sckzor/CMOS_LNB/Layout/Layout.md

# Low Noise Amplifier Layout
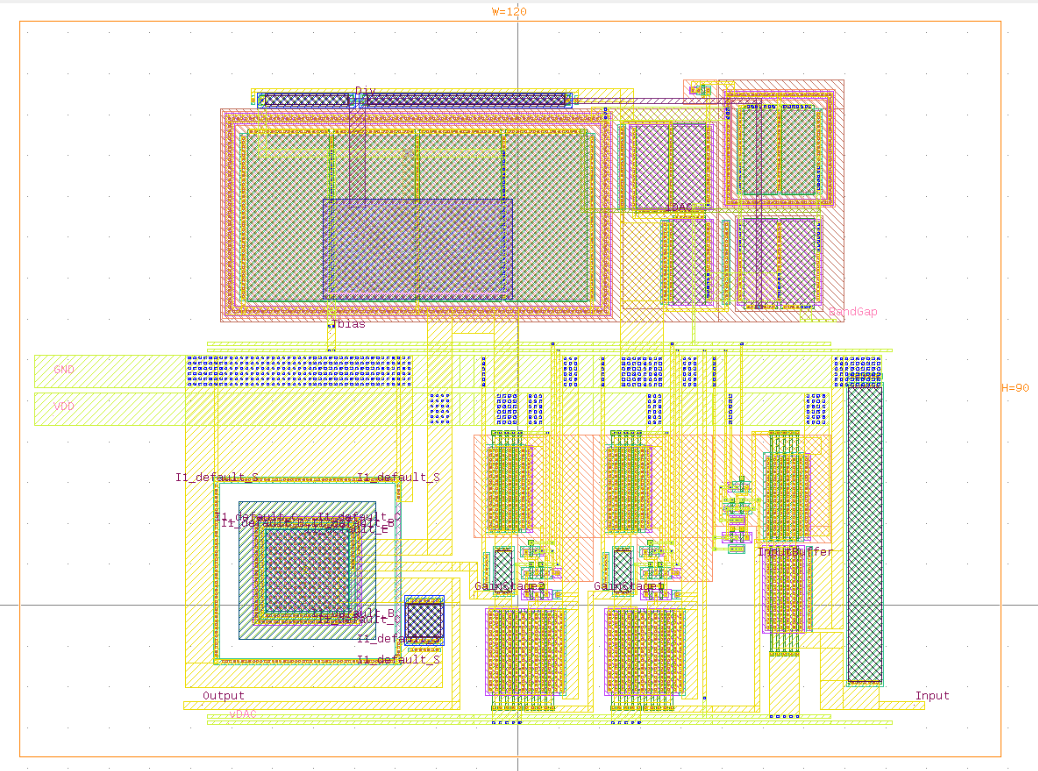
[picture p3: Images/LNA_Layout.png]
LNA Layout


*LNA Layout GDS files available at: /Layout/LNA/LNAMkV.klay.gds*

Above is the layout for the L-Band LNA presented prior.  The simulation test results are available [here](/Layout/LNA/Simulations.md).

## Input Buffer
### Input Buffer Layout
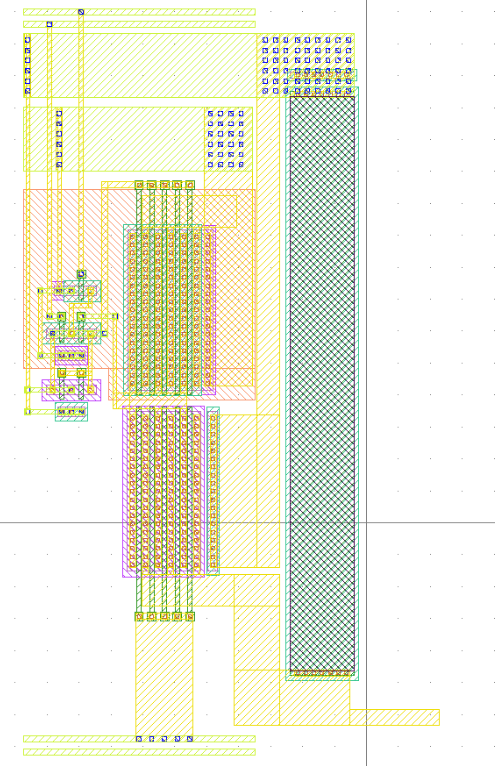
[picture p4: Images/InputBuffer_Layout.png]
Input Buffer Layout


### Input Buffer Layout Driven Schematic
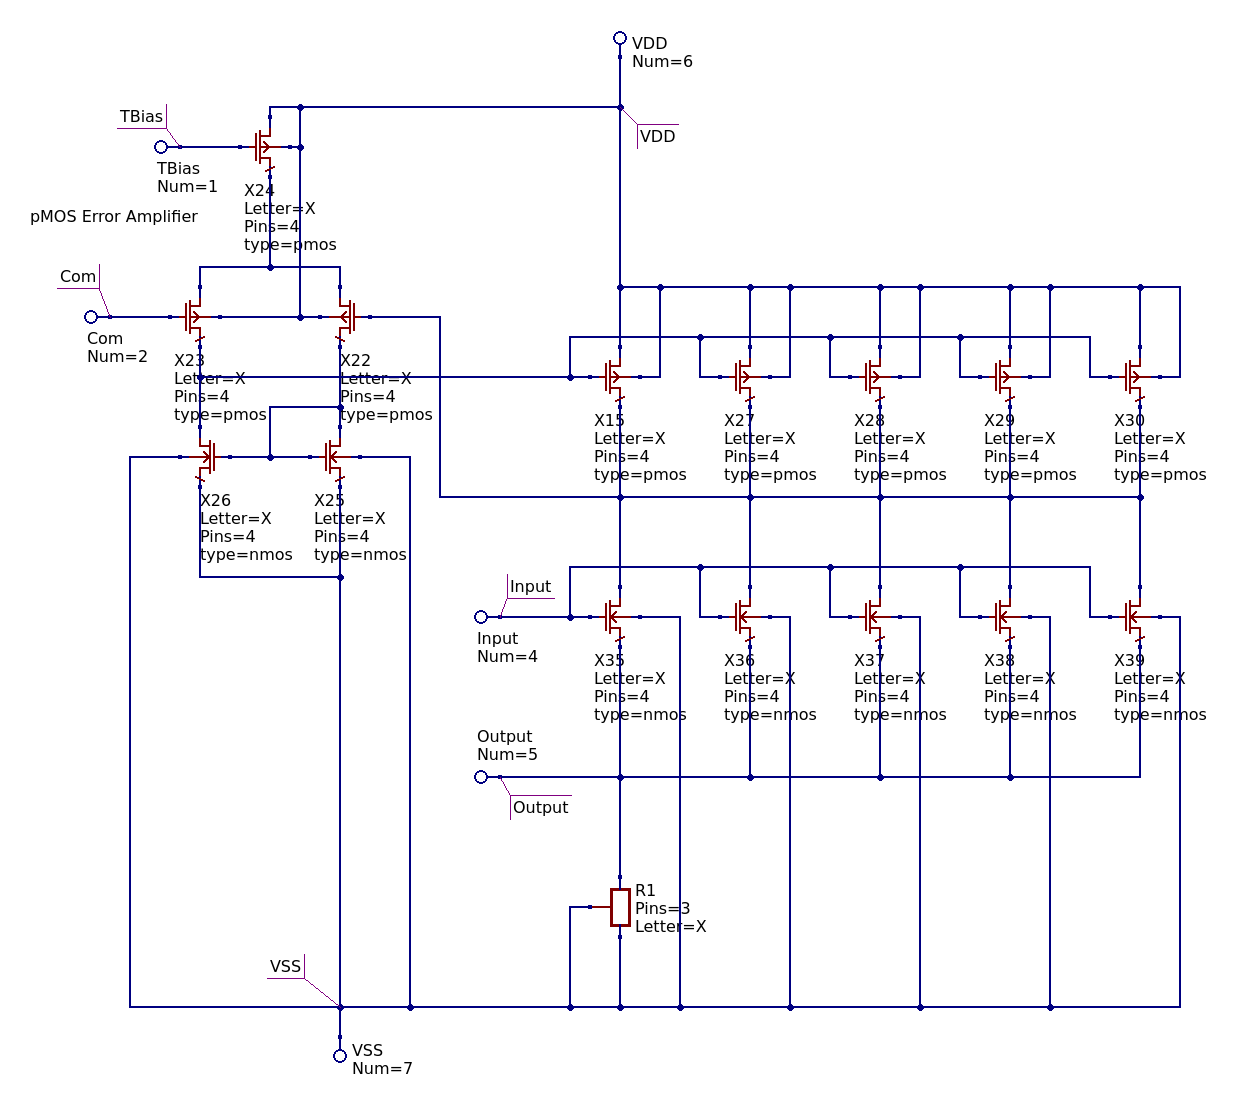
[picture p5: Images/InputBuffer_LDS.png]
Input Buffer LDS

*The LVS schematic is available at: /Schematic/Input Buffer/InputBufferMkI_LVS.sch*

### Input Buffer LVS Results
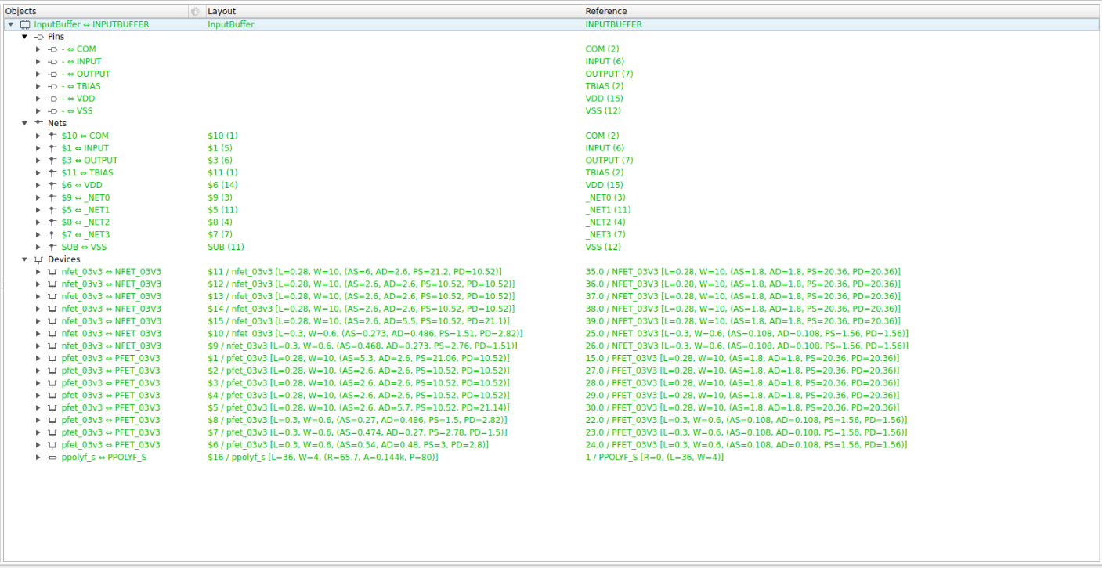
[picture p6: Images/InputBuffer_LVS.png]
Input Buffer LVS


## Gain Stage
### Gain Stage Layout
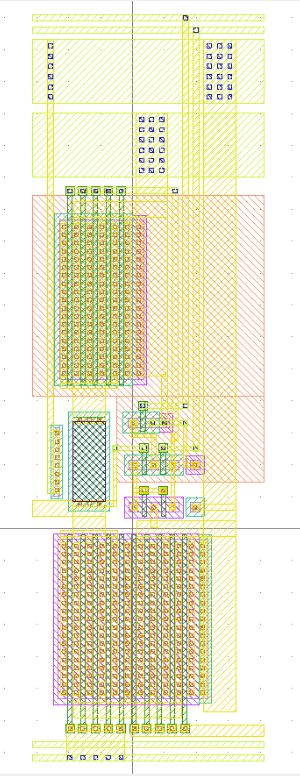
[picture p7: Images/GainStage_Layout.png]
Gain Stage Layout


### Gain Stage Layout Driven Schematic
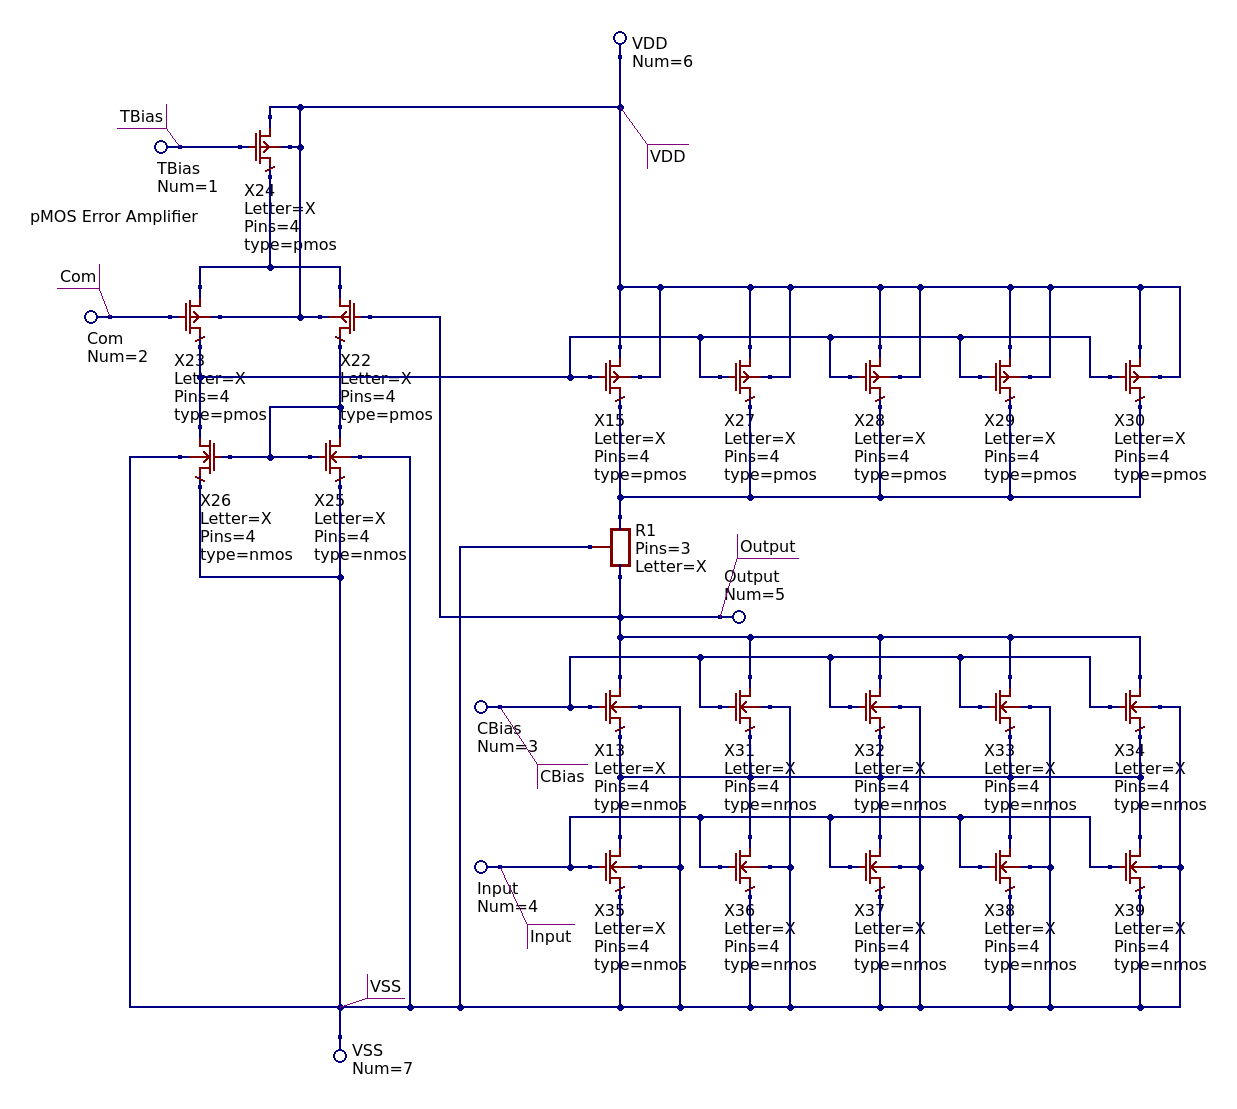
[picture p8: Images/GainStage_LDS.png]
Gain Stage LDS

*The LVS schematic is available at: /Schematic/Gain Stage/GainStageMkII_LVS.sch*

### Gain Stage LVS Results
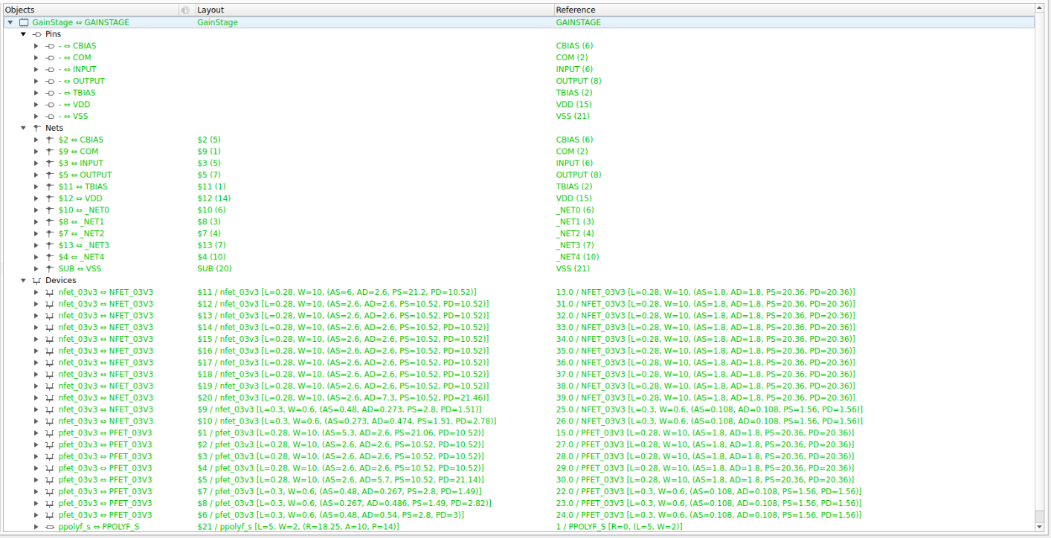
[picture p9: Images/GainStage_LVS.png]
Gain Stage LVS


## Output Buffer
### Output Buffer Layout
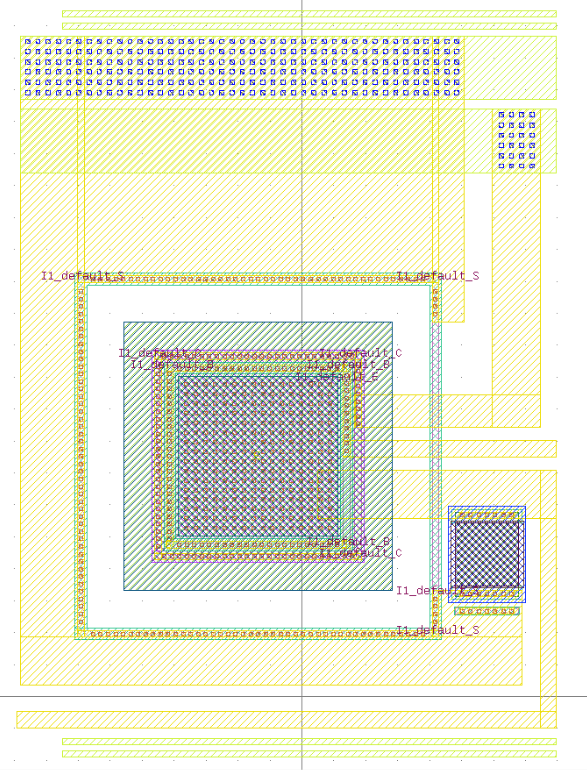
[picture p10: Images/OutputBuffer_Layout.png]
Output Buffer Layout


### Output Buffer Layout Driven Schematic
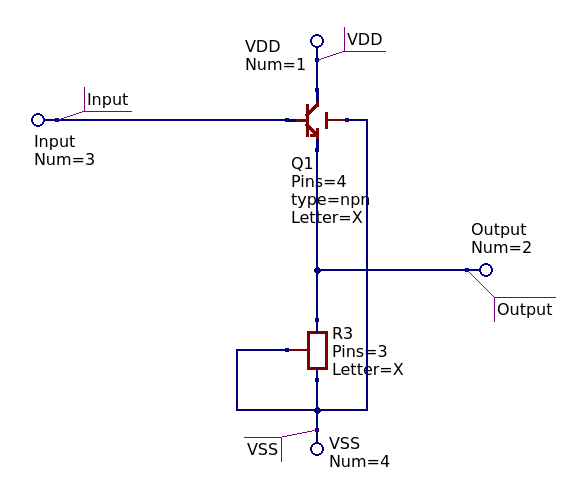
[picture p11: Images/OutputBuffer_LDS.png]
Output Buffer LDS

*The LVS schematic is available at: /Schematic/Output Buffer/OutputBufferMkVI_LVS.sch*

### Output Buffer LVS Results
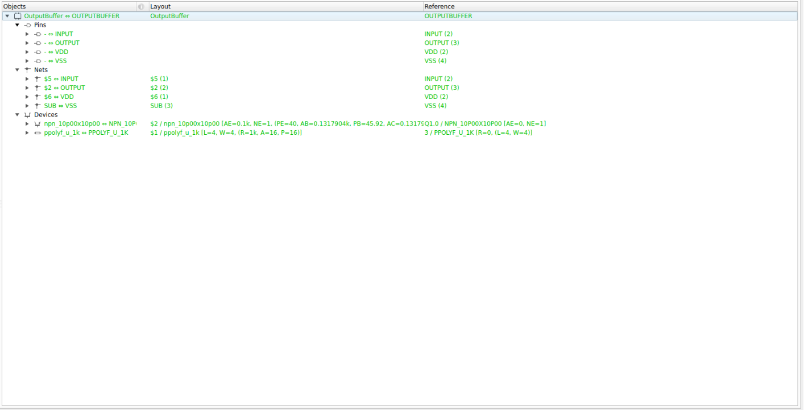
[picture p12: Images/OutputBuffer_LVS.png]
Output Buffer LVS


## Reference
### Reference Laypout
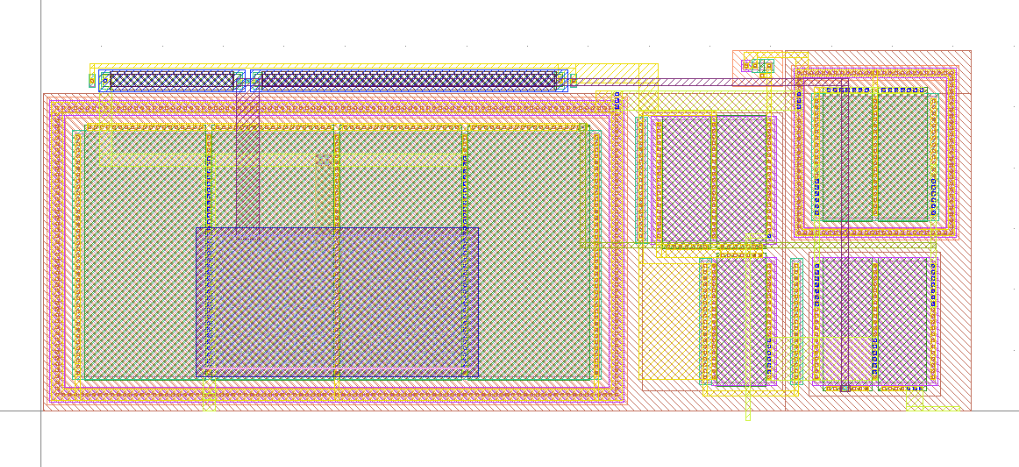
[picture p13: Images/Reference_Layout.png]
Reference LVS


### Reference LVS Results
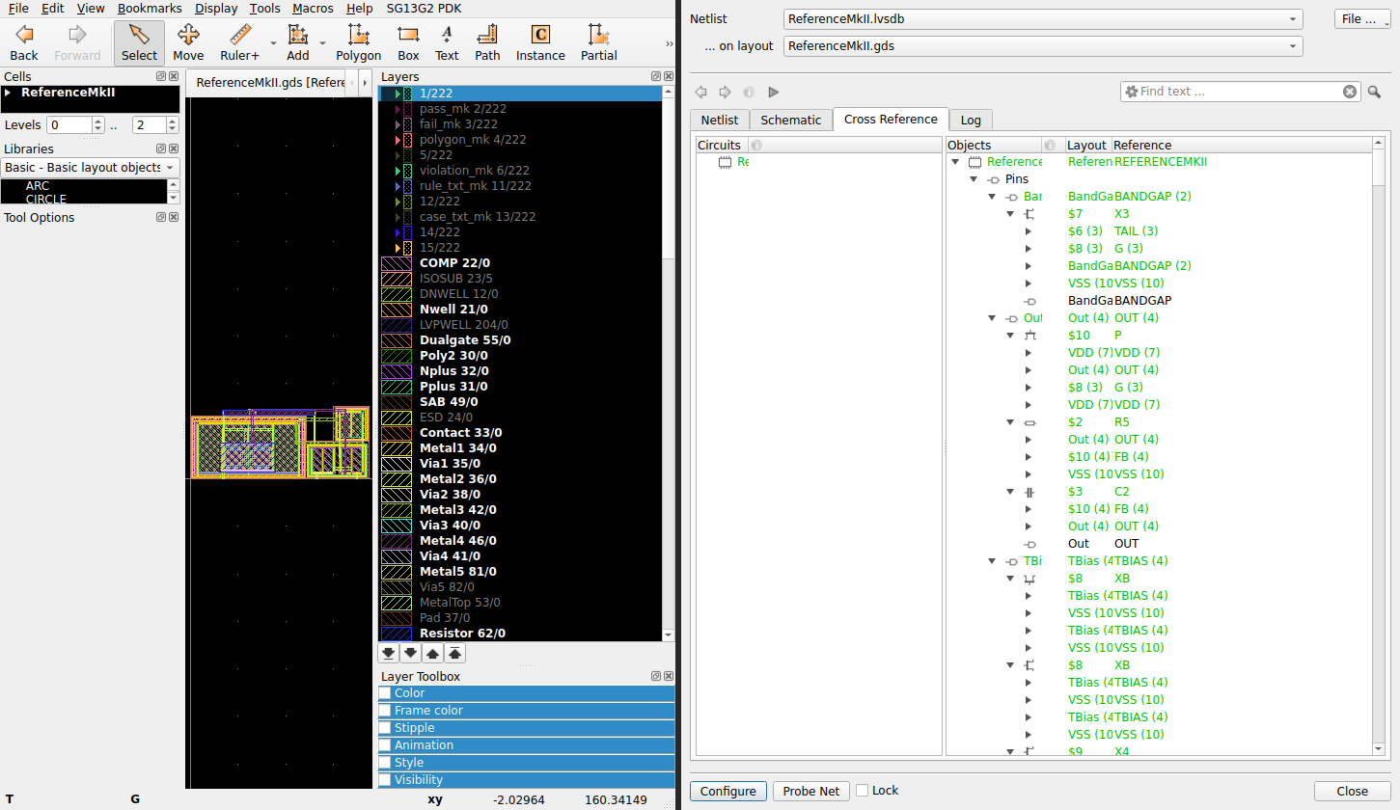
[picture p14: Images/Reference_LVS.png]
Reference LVS


## Pad
