sckzor/CMOS_LNB/Images/LNA_DRC.png

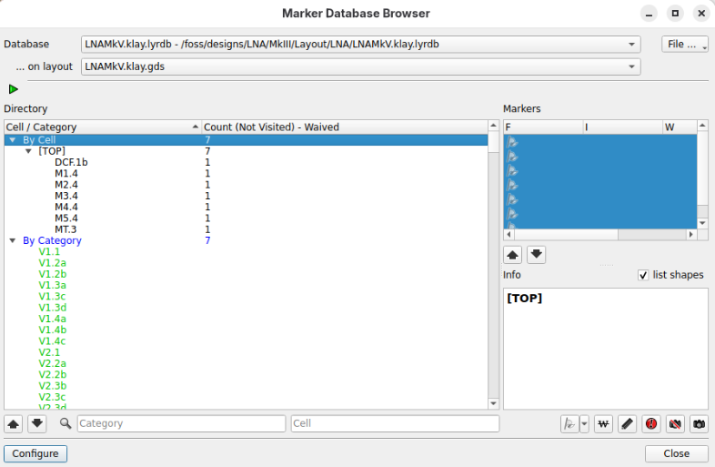
Images/LNA_DRC.png
