sckzor/CMOS_LNB/Images/LNA_Layout_S22.png

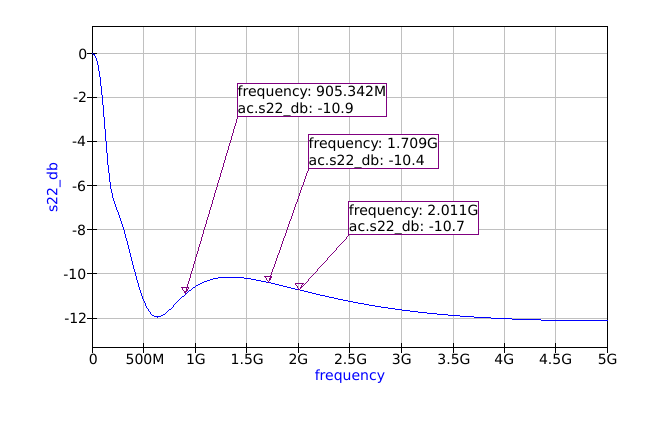
Images/LNA_Layout_S22.png
