sckzor/CMOS_LNB/Images/LNA_Layout_Transient.png

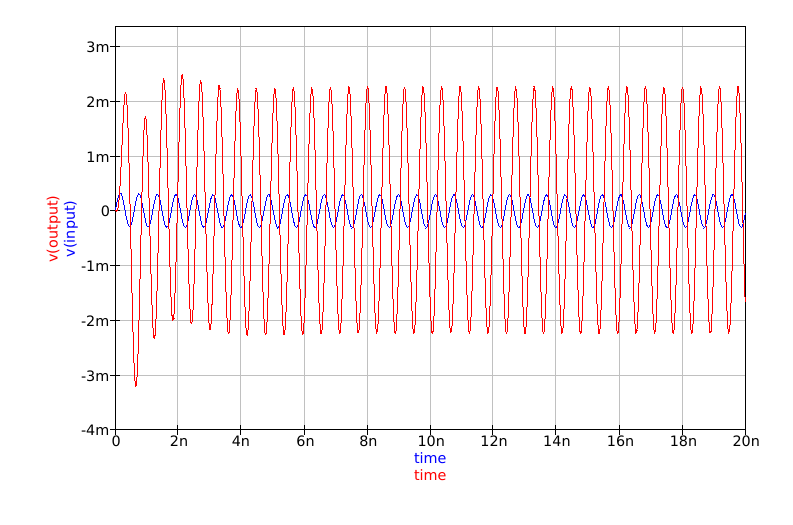
Images/LNA_Layout_Transient.png
