sckzor/CMOS_LNB/Images/Ring_Oscillator_Freq_FF.png

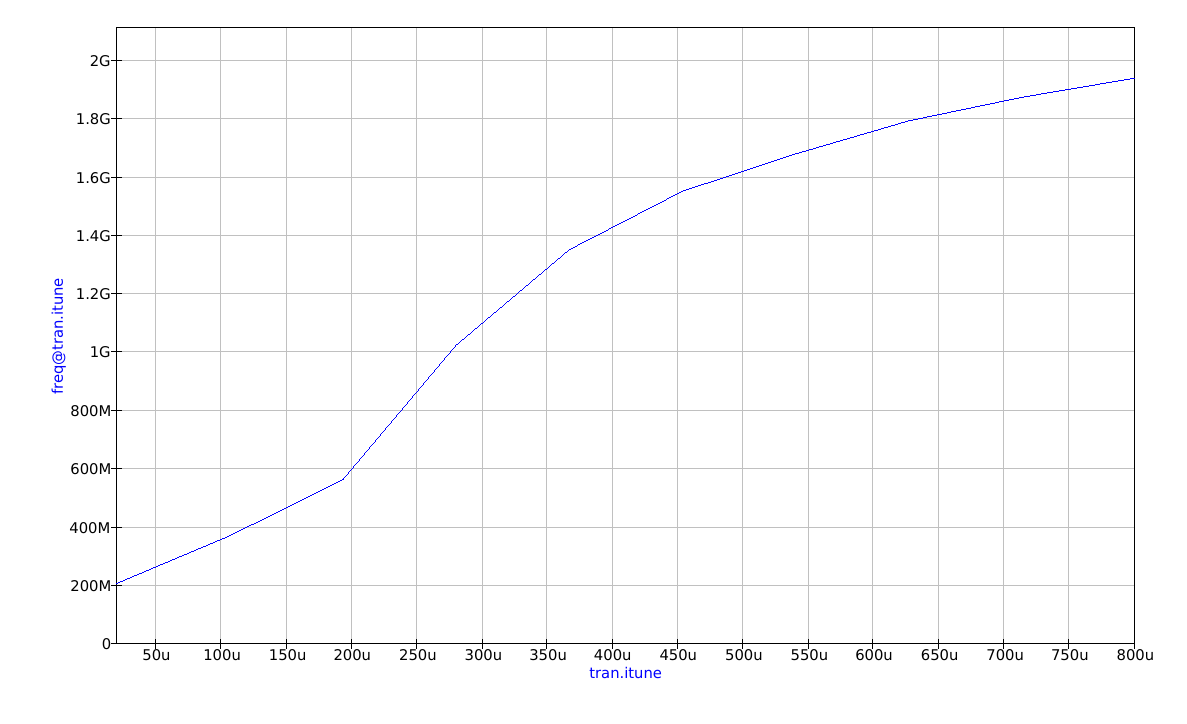
Images/Ring_Oscillator_Freq_FF.png
