sckzor/CMOS_LNB/Images/Ring_Oscillator_Freq_FS.png

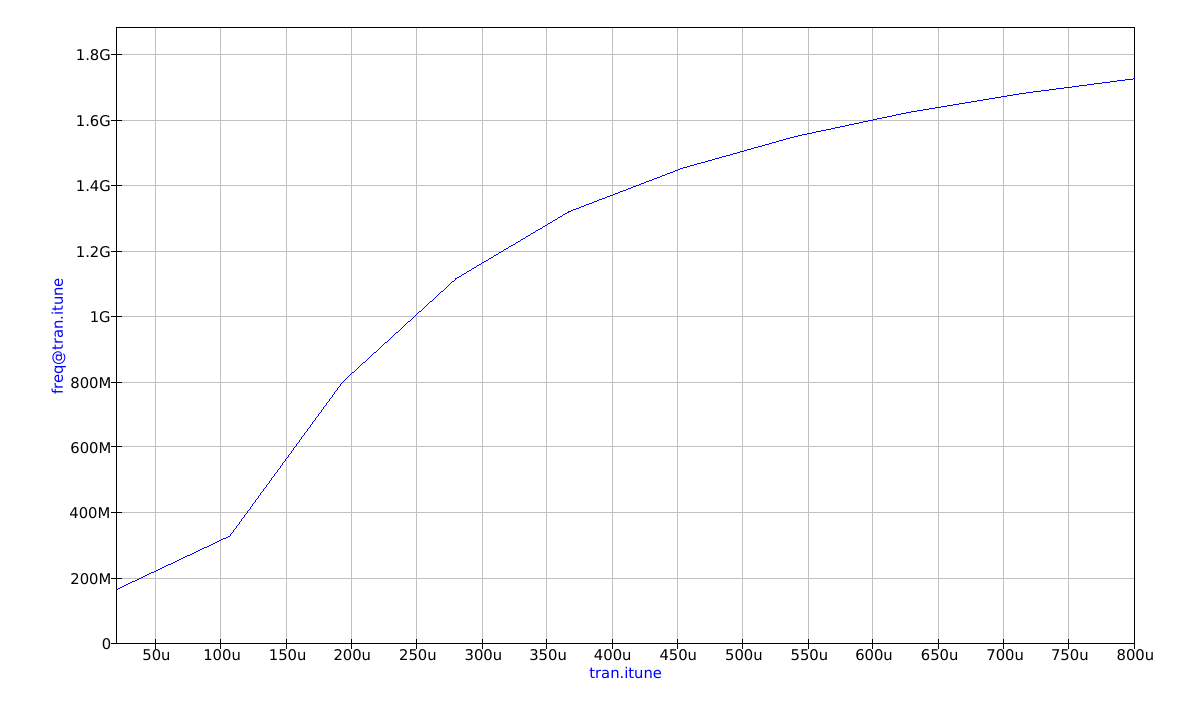
Images/Ring_Oscillator_Freq_FS.png
