sckzor/CMOS_LNB/Images/Ring_Oscillator_Freq_SS.png

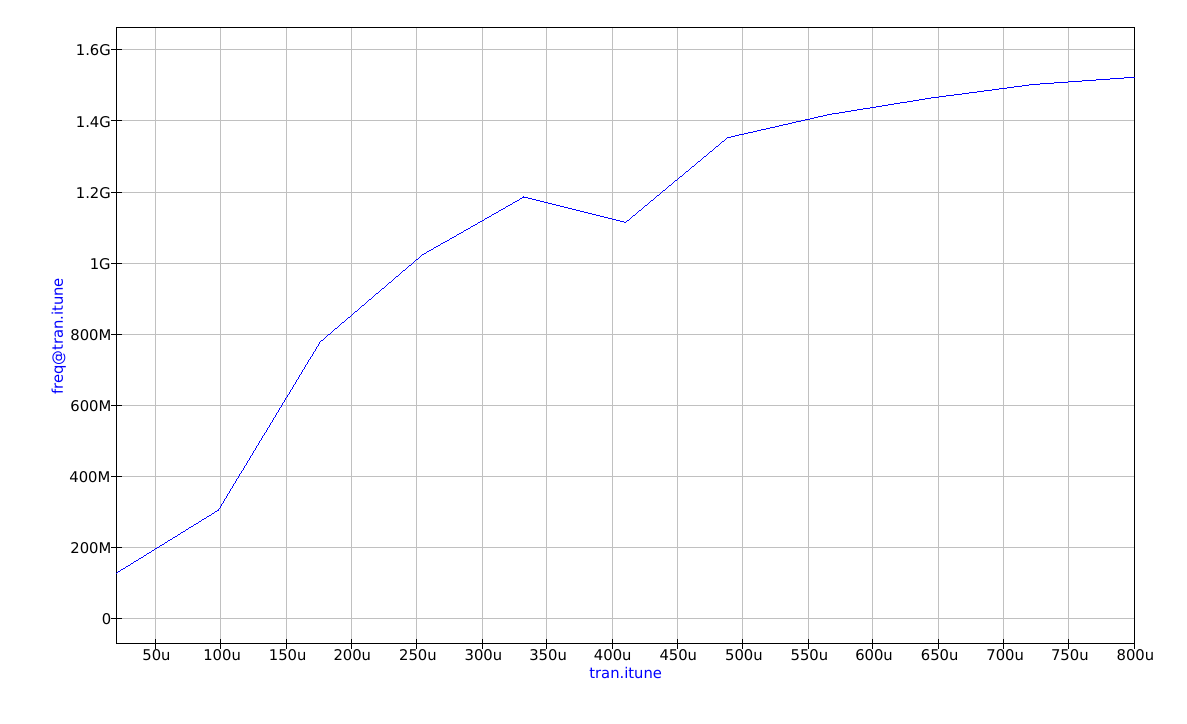
Images/Ring_Oscillator_Freq_SS.png
