sckzor/CMOS_LNB/Layout/Pad/Characterization.md

# Pad Characterization
## Nominal Pad
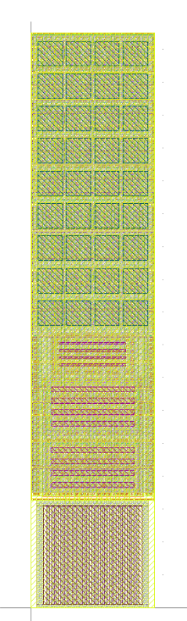
[picture p34: Images/NominalPad.png]
Nominal Pad


## Low Loss Pad
This pad has half the amount of ESD protection

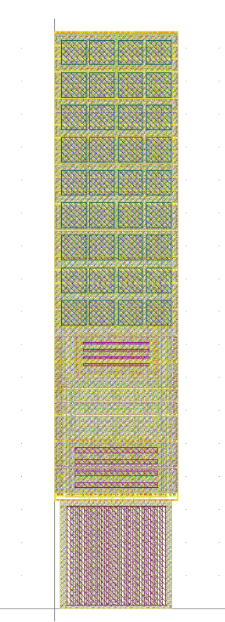
[picture p35: Images/Low_Loss_Pad.png]
Low Loss Pad


## S Parameters
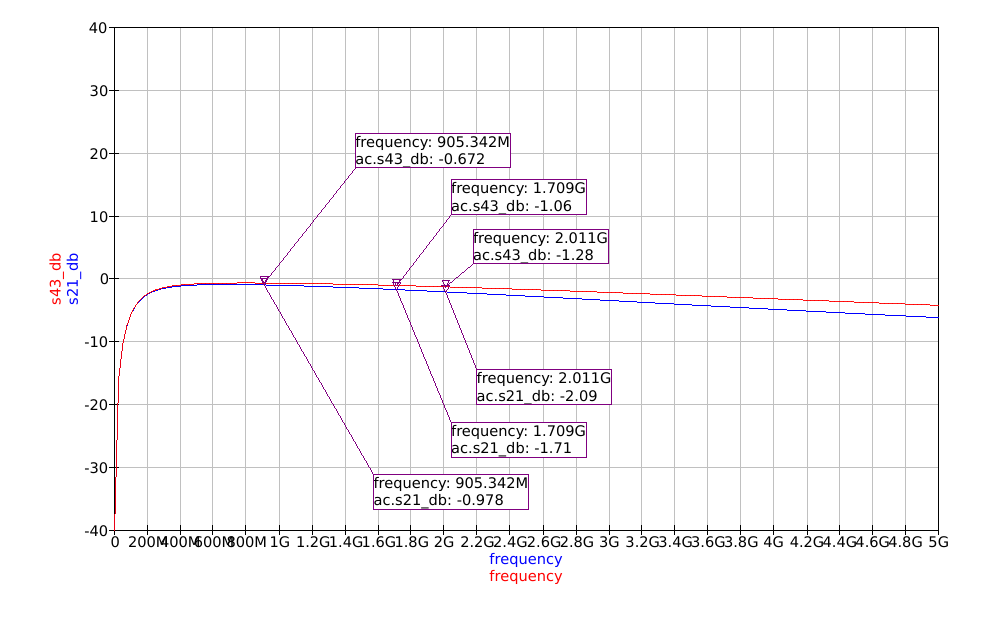
[picture p36: Images/LNA_Pad_Comparison.png]
Pad S Parameters
