sckzor/CMOS_LNB/Layout/LNA/output/LNAMkV__TOP/magic_RC/TOP.pex.spice

* NGSPICE file created from TOP.ext - technology: gf180mcuD

.subckt TOP iDAC Tbias Div GainStage1 GainStage2 InputBuffer Input Output vDAC BandGap
+ GND VDD
X0 InputBuffer a_5048_1590# VDD.t31 VDD.t30 pfet_03v3 ad=2.6p pd=10.52u as=2.6p ps=10.52u w=10u l=0.28u
X1 GND.t14 a_150_194# a_150_194# GND.t15 nfet_03v3 ad=0.273p pd=1.51u as=0.48p ps=2.8u w=0.6u l=0.3u
X2 a_2346_n2146# InputBuffer GND.t11 GND.t40 nfet_03v3 ad=2.6p pd=10.52u as=2.6p ps=10.52u w=10u l=0.28u
X3 Input Tbias InputBuffer GND.t4 nfet_03v3 ad=2.6p pd=10.52u as=2.6p ps=10.52u w=10u l=0.28u
X4 a_2264_4164# a_3058_194# GND.t11 GND.t12 nfet_03v3 ad=0.474p pd=2.78u as=0.273p ps=1.51u w=0.6u l=0.3u
X5 a_2346_n2146# vDAC GainStage1 GND.t29 nfet_03v3 ad=2.6p pd=10.52u as=6p ps=21.2u w=10u l=0.28u
X6 GND.t11 InputBuffer a_2346_n2146# GND.t43 nfet_03v3 ad=13.2p pd=22.64u as=2.6p ps=10.52u w=10u l=0.28u
X7 a_n562_n2146# vDAC GainStage2 GND.t26 nfet_03v3 ad=2.6p pd=10.52u as=2.6p ps=10.52u w=10u l=0.28u
X8 GainStage1 vDAC a_2346_n2146# GND.t32 nfet_03v3 ad=2.6p pd=10.52u as=2.6p ps=10.52u w=10u l=0.28u
X9 InputBuffer Tbias Input GND.t4 nfet_03v3 ad=2.6p pd=10.52u as=2.6p ps=10.52u w=10u l=0.28u
X10 a_4598_7392# iDAC GND.t6 GND.t5 nfet_06v0 ad=7.3p pd=21.46u as=13p ps=22.6u w=10u l=4u
X11 a_n6608_7424# BandGap a_4598_7392# GND.t0 nfet_06v0 ad=7.3p pd=21.46u as=2.6p ps=10.52u w=10u l=4u
X12 a_5182_1808# InputBuffer a_5266_2300# VDD.t22 pfet_03v3 ad=0.486p pd=2.82u as=0.27p ps=1.5u w=0.6u l=0.3u
X13 VDD.t1 a_n6608_7424# Tbias VDD.t10 pfet_06v0 ad=5.2p pd=20.52u as=5.2p ps=20.52u w=20u l=10u
X14 VDD.t19 a_268_1472# a_3042_1254# VDD.t15 pfet_03v3 ad=0.9p pd=4.2u as=0.48p ps=2.8u w=0.6u l=0.3u
X15 GND.t11 InputBuffer a_2346_n2146# GND.t39 nfet_03v3 ad=2.6p pd=10.52u as=2.6p ps=10.52u w=10u l=0.28u
X16 VDD.t1 a_n644_4164# a_n724_1852# VDD.t0 pfet_03v3 ad=2.6p pd=10.52u as=2.6p ps=10.52u w=10u l=0.28u
X17 a_2346_n2146# InputBuffer GND.t11 GND.t42 nfet_03v3 ad=2.6p pd=10.52u as=2.6p ps=10.52u w=10u l=0.28u
X18 a_n724_1852# a_n644_4164# VDD.t1 VDD.t0 pfet_03v3 ad=2.6p pd=10.52u as=2.6p ps=10.52u w=10u l=0.28u
X19 a_2184_1852# a_2264_4164# VDD.t1 VDD.t25 pfet_03v3 ad=2.6p pd=10.52u as=2.6p ps=10.52u w=10u l=0.28u
X20 VDD.t31 a_5048_1590# InputBuffer VDD.t30 pfet_03v3 ad=2.6p pd=10.52u as=2.6p ps=10.52u w=10u l=0.28u
X21 a_134_1254# GainStage2 a_150_194# VDD.t7 pfet_03v3 ad=0.267p pd=1.49u as=0.48p ps=2.8u w=0.6u l=0.3u
X22 Tbias Div GND.t19 ppolyf_u_1k r_width=1u r_length=10u
X23 VDD.t13 a_n6608_7424# Tbias VDD.t12 pfet_06v0 ad=15.4p pd=41.54u as=5.2p ps=20.52u w=20u l=10u
X24 InputBuffer a_5048_1590# VDD.t31 VDD.t30 pfet_03v3 ad=2.6p pd=10.52u as=2.6p ps=10.52u w=10u l=0.28u
X25 GND.t11 a_3058_194# a_3058_194# GND.t10 nfet_03v3 ad=0.273p pd=1.51u as=0.48p ps=2.8u w=0.6u l=0.3u
X26 Input Tbias InputBuffer GND.t4 nfet_03v3 ad=2.6p pd=10.52u as=6p ps=21.2u w=10u l=0.28u
X27 a_n644_4164# Tbias a_134_1254# VDD.t7 pfet_03v3 ad=0.486p pd=2.82u as=0.267p ps=1.49u w=0.6u l=0.3u
X28 Tbias Div cap_mim_2f0_m4m5_noshield c_width=22u c_length=11u
X29 a_n6608_7424# a_5390_10102# VDD.t17 VDD.t18 pfet_06v0 ad=7.7p pd=21.54u as=2.6p ps=10.52u w=10u l=4u
X30 Input Tbias InputBuffer GND.t4 nfet_03v3 ad=5.5p pd=21.1u as=2.6p ps=10.52u w=10u l=0.28u
X31 VDD GainStage2 Output GND npn_10p00x10p00
X32 GND.t8 iDAC iDAC GND.t7 nfet_06v0 ad=2.6p pd=10.52u as=7.3p ps=21.46u w=10u l=4u
X33 a_2184_1852# GainStage1 GND.t44 ppolyf_s r_width=2u r_length=5u
X34 GND.t14 GainStage1 a_n562_n2146# GND.t36 nfet_03v3 ad=2.6p pd=10.52u as=2.6p ps=10.52u w=10u l=0.28u
X35 Div GND.t8 GND.t20 ppolyf_u_1k r_width=1u r_length=24u
X36 a_n724_1852# GainStage2 GND.t17 ppolyf_s r_width=2u r_length=5u
X37 Output GND GND.t18 ppolyf_u_1k r_width=4u r_length=4u
X38 VDD.t17 a_5390_10102# a_5390_10102# VDD.t16 pfet_06v0 ad=2.6p pd=10.52u as=7.7p ps=21.54u w=10u l=4u
X39 VDD.t1 a_2264_4164# a_2184_1852# VDD.t24 pfet_03v3 ad=2.6p pd=10.52u as=5.3p ps=21.06u w=10u l=0.28u
X40 Tbias a_n6608_7424# VDD.t1 VDD.t11 pfet_06v0 ad=5.2p pd=20.52u as=5.2p ps=20.52u w=20u l=10u
X41 GND Input GND.t1 ppolyf_s r_width=4u r_length=36u
X42 VDD.t21 a_268_1472# a_134_1254# VDD.t7 pfet_03v3 ad=0.9p pd=4.2u as=0.48p ps=2.8u w=0.6u l=0.3u
X43 GainStage2 vDAC a_n562_n2146# GND.t27 nfet_03v3 ad=2.6p pd=10.52u as=2.6p ps=10.52u w=10u l=0.28u
X44 a_268_1472# iDAC GND.t8 GND.t5 nfet_06v0 ad=7.3p pd=21.46u as=2.6p ps=10.52u w=10u l=4u
X45 VDD.t1 a_n644_4164# a_n724_1852# VDD.t0 pfet_03v3 ad=2.6p pd=10.52u as=5.3p ps=21.06u w=10u l=0.28u
X46 VDD.t31 a_5048_1590# InputBuffer VDD.t30 pfet_03v3 ad=2.6p pd=10.52u as=5.3p ps=21.06u w=10u l=0.28u
X47 a_n562_n2146# vDAC GainStage2 GND.t24 nfet_03v3 ad=2.6p pd=10.52u as=6p ps=21.2u w=10u l=0.28u
X48 a_2346_n2146# vDAC GainStage1 GND.t31 nfet_03v3 ad=2.6p pd=10.52u as=2.6p ps=10.52u w=10u l=0.28u
X49 VDD.t29 a_2264_4164# a_2184_1852# VDD.t28 pfet_03v3 ad=12.9p pd=22.58u as=2.6p ps=10.52u w=10u l=0.28u
X50 a_5266_2300# a_268_1472# VDD.t23 VDD.t22 pfet_03v3 ad=0.48p pd=2.8u as=0.9p ps=4.2u w=0.6u l=0.3u
X51 a_3042_1254# GainStage1 a_3058_194# VDD.t15 pfet_03v3 ad=0.267p pd=1.49u as=0.48p ps=2.8u w=0.6u l=0.3u
X52 a_2264_4164# Tbias a_3042_1254# VDD.t15 pfet_03v3 ad=0.486p pd=2.82u as=0.267p ps=1.49u w=0.6u l=0.3u
X53 a_n562_n2146# GainStage1 GND.t14 GND.t35 nfet_03v3 ad=2.6p pd=10.52u as=2.6p ps=10.52u w=10u l=0.28u
X54 Tbias a_n6608_7424# VDD.t9 VDD.t8 pfet_06v0 ad=5.2p pd=20.52u as=15.4p ps=41.54u w=20u l=10u
X55 VDD.t31 a_5048_1590# InputBuffer VDD.t30 pfet_03v3 ad=12.9p pd=22.58u as=2.6p ps=10.52u w=10u l=0.28u
X56 a_n644_4164# a_150_194# GND.t14 GND.t13 nfet_03v3 ad=0.474p pd=2.78u as=0.273p ps=1.51u w=0.6u l=0.3u
X57 GND.t14 GainStage1 a_n562_n2146# GND.t38 nfet_03v3 ad=13.2p pd=22.64u as=2.6p ps=10.52u w=10u l=0.28u
X58 InputBuffer Tbias Input GND.t4 nfet_03v3 ad=2.6p pd=10.52u as=2.6p ps=10.52u w=10u l=0.28u
X59 a_5182_1808# a_5182_1808# GND.t22 GND.t21 nfet_03v3 ad=0.486p pd=2.82u as=0.273p ps=1.51u w=0.6u l=0.3u
X60 a_5266_2300# Tbias a_5048_1590# VDD.t14 pfet_03v3 ad=0.27p pd=1.5u as=0.474p ps=2.78u w=0.6u l=0.3u
X61 GND.t11 InputBuffer a_2346_n2146# GND.t41 nfet_03v3 ad=2.6p pd=10.52u as=2.6p ps=10.52u w=10u l=0.28u
X62 a_n562_n2146# vDAC GainStage2 GND.t28 nfet_03v3 ad=2.6p pd=10.52u as=2.6p ps=10.52u w=10u l=0.28u
X63 VDD.t1 a_n644_4164# a_n724_1852# VDD.t0 pfet_03v3 ad=12.9p pd=22.58u as=2.6p ps=10.52u w=10u l=0.28u
X64 GainStage2 vDAC a_n562_n2146# GND.t25 nfet_03v3 ad=2.6p pd=10.52u as=2.6p ps=10.52u w=10u l=0.28u
X65 GainStage1 vDAC a_2346_n2146# GND.t30 nfet_03v3 ad=2.6p pd=10.52u as=2.6p ps=10.52u w=10u l=0.28u
X66 a_2346_n2146# vDAC GainStage1 GND.t33 nfet_03v3 ad=2.6p pd=10.52u as=2.6p ps=10.52u w=10u l=0.28u
X67 a_268_1472# a_268_1472# VDD.t20 VDD.t20 pfet_03v3 ad=0.39p pd=2.5u as=0.828p ps=3.96u w=0.6u l=0.3u
X68 GND.t14 GainStage1 a_n562_n2146# GND.t34 nfet_03v3 ad=2.6p pd=10.52u as=2.6p ps=10.52u w=10u l=0.28u
X69 a_4598_7392# Div a_5390_10102# GND.t16 nfet_06v0 ad=2.6p pd=10.52u as=7.3p ps=21.46u w=10u l=4u
X70 a_n724_1852# a_n644_4164# VDD.t1 VDD.t0 pfet_03v3 ad=2.6p pd=10.52u as=2.6p ps=10.52u w=10u l=0.28u
X71 a_2184_1852# a_2264_4164# VDD.t1 VDD.t27 pfet_03v3 ad=2.6p pd=10.52u as=2.6p ps=10.52u w=10u l=0.28u
X72 GND.t22 a_5182_1808# a_5048_1590# GND.t21 nfet_03v3 ad=0.273p pd=1.51u as=0.468p ps=2.76u w=0.6u l=0.3u
X73 a_n562_n2146# GainStage1 GND.t14 GND.t37 nfet_03v3 ad=2.6p pd=10.52u as=2.6p ps=10.52u w=10u l=0.28u
X74 VDD.t1 a_2264_4164# a_2184_1852# VDD.t26 pfet_03v3 ad=2.6p pd=10.52u as=2.6p ps=10.52u w=10u l=0.28u
C0 a_n6608_7424# Tbias 10.3651f
C1 a_n644_4164# a_134_1254# 0.05137f
C2 a_268_1472# GainStage2 0.01049f
C3 a_5048_1590# VDD 3.33737f
C4 a_n644_4164# Tbias 0.10264f
C5 GainStage2 a_150_194# 0.09972f
C6 a_n6608_7424# VDD 15.3632f
C7 a_5390_10102# iDAC 0.04976f
C8 a_2184_1852# GainStage1 0.01606f
C9 a_268_1472# a_134_1254# 0.02289f
C10 InputBuffer Tbias 1.14307f
C11 a_n644_4164# VDD 4.33242f
C12 InputBuffer vDAC 0.11425f
C13 a_2346_n2146# InputBuffer 0.7636f
C14 InputBuffer a_5266_2300# 0.09075f
C15 a_268_1472# Tbias 7.2828f
C16 a_150_194# a_134_1254# 0.03453f
C17 a_268_1472# a_5266_2300# 0.02078f
C18 GainStage1 Tbias 0.24313f
C19 a_268_1472# a_3042_1254# 0.02289f
C20 InputBuffer VDD 3.5801f
C21 vDAC GainStage1 0.60788f
C22 a_2346_n2146# GainStage1 2.86857f
C23 Tbias a_150_194# 0.01404f
C24 a_n724_1852# VDD 3.10974f
C25 a_3042_1254# GainStage1 0.08905f
C26 Div a_5390_10102# 0.82815f
C27 a_n6608_7424# a_4598_7392# 0.08613f
C28 a_268_1472# VDD 4.49518f
C29 a_3058_194# Tbias 0.01424f
C30 GainStage1 VDD 0.31631f
C31 a_3058_194# a_3042_1254# 0.03453f
C32 a_150_194# VDD 0.0884f
C33 a_5048_1590# InputBuffer 0.79662f
C34 BandGap VDD 0.0699f
C35 a_3058_194# VDD 0.0884f
C36 a_5048_1590# a_268_1472# 0.11822f
C37 a_268_1472# a_n6608_7424# 0.26838f
C38 a_268_1472# a_4598_7392# 0.15286f
C39 a_n724_1852# a_n644_4164# 0.50497f
C40 a_2264_4164# a_2184_1852# 0.50497f
C41 a_268_1472# a_n644_4164# 1.26225f
C42 a_5182_1808# a_5266_2300# 0.0256f
C43 iDAC VDD 0.25445f
C44 a_n6608_7424# BandGap 0.4606f
C45 a_4598_7392# BandGap 0.43871f
C46 a_5182_1808# VDD 0.27798f
C47 a_n644_4164# a_150_194# 0.07007f
C48 a_2264_4164# Tbias 0.10347f
C49 a_268_1472# InputBuffer 0.01161f
C50 Div Tbias 1.81445f
C51 a_2264_4164# a_3042_1254# 0.05137f
C52 GainStage2 a_n562_n2146# 2.85729f
C53 a_268_1472# GainStage1 0.01051f
C54 a_2264_4164# VDD 4.27269f
C55 Div VDD 1.42408f
C56 a_5048_1590# a_5182_1808# 0.12549f
C57 a_n6608_7424# iDAC 0.42706f
C58 a_4598_7392# iDAC 0.39665f
C59 a_268_1472# BandGap 0.04631f
C60 a_3058_194# GainStage1 0.09951f
C61 Input Tbias 0.9987f
C62 GainStage2 Output 3.12452f
C63 a_5390_10102# VDD 3.92735f
C64 a_n562_n2146# Tbias 0.05957f
C65 Input vDAC 0.09435f
C66 GainStage2 a_134_1254# 0.08905f
C67 vDAC a_n562_n2146# 0.764f
C68 a_n6608_7424# Div 1.93615f
C69 a_4598_7392# Div 1.13444f
C70 GainStage2 Tbias 0.03142f
C71 InputBuffer a_5182_1808# 0.07538f
C72 a_268_1472# iDAC 1.03214f
C73 GainStage2 vDAC 0.49348f
C74 Tbias Output 0.55653f
C75 GainStage2 VDD 3.49646f
C76 a_n6608_7424# a_5390_10102# 0.60195f
C77 vDAC Output 0.06567f
C78 a_4598_7392# a_5390_10102# 0.35936f
C79 Tbias a_134_1254# 0.05126f
C80 a_268_1472# a_2264_4164# 1.26251f
C81 a_268_1472# Div 0.09204f
C82 a_2184_1852# VDD 3.11074f
C83 VDD Output 0.07299f
C84 vDAC Tbias 3.30819f
C85 a_2346_n2146# Tbias 0.06208f
C86 Tbias a_5266_2300# 0.06484f
C87 a_3042_1254# Tbias 0.05126f
C88 VDD a_134_1254# 0.18232f
C89 a_2346_n2146# vDAC 0.764f
C90 Tbias VDD 6.28319f
C91 a_3058_194# a_2264_4164# 0.07007f
C92 Div BandGap 0.12317f
C93 a_268_1472# a_5390_10102# 0.04164f
C94 a_5266_2300# VDD 0.18831f
C95 a_3042_1254# VDD 0.18232f
C96 Input InputBuffer 2.88684f
C97 a_5390_10102# BandGap 0.02439f
C98 a_5048_1590# Tbias 0.05851f
C99 a_n562_n2146# GainStage1 0.76533f
C100 Div iDAC 0.13722f
C101 a_n724_1852# GainStage2 0.01606f
C102 a_5048_1590# a_5266_2300# 0.11052f
R0 VDD.n26 VDD.n25 569.928
R1 VDD.n14 VDD.t30 562.947
R2 VDD.t24 VDD.n19 555.644
R3 VDD.t10 VDD.t8 416.139
R4 VDD.t11 VDD.t12 416.139
R5 VDD.n25 VDD.t15 304.104
R6 VDD.n19 VDD.t7 304.104
R7 VDD.t12 VDD.n5 285.728
R8 VDD.t16 VDD.t20 278.125
R9 VDD.t18 VDD.n6 277.664
R10 VDD.n19 VDD.t0 258.348
R11 VDD.n25 VDD.n24 258.348
R12 VDD.n3 VDD.t8 286.495
R13 VDD.n4 VDD.n5 1.22612
R14 VDD.t1 VDD.t10 208.071
R15 VDD.t1 VDD.t11 208.071
R16 VDD.n10 VDD.n6 172.635
R17 VDD.n8 VDD.n6 172.635
R18 VDD.n9 VDD.t18 157.292
R19 VDD.n9 VDD.t16 156.597
R20 VDD.n8 VDD.n2 0.230493
R21 VDD.t20 VDD.n0 2.02164
R22 VDD.n24 VDD.t28 87.4409
R23 VDD.n25 VDD.n16 70.8511
R24 VDD.n19 VDD.n17 70.8511
R25 VDD.t25 VDD.t24 63.5935
R26 VDD.t26 VDD.t25 63.5935
R27 VDD.t27 VDD.t26 63.5935
R28 VDD.t28 VDD.t27 63.5935
R29 VDD.t14 VDD.n15 54.4648
R30 VDD.n15 VDD.t22 52.6791
R31 VDD.n27 VDD.n26 12.5005
R32 VDD.n30 VDD.n29 11.2114
R33 VDD.n29 VDD.n28 10.8005
R34 VDD.t19 VDD.n16 9.90943
R35 VDD.t21 VDD.n17 9.90943
R36 VDD.n30 VDD.t23 9.90943
R37 VDD.n14 VDD.n12 8.82301
R38 VDD.n20 VDD.t19 8.4005
R39 VDD.n18 VDD.t21 8.4005
R40 VDD.t23 VDD.n11 8.4005
R41 VDD.n28 VDD.n13 6.5105
R42 VDD.n26 VDD.n11 6.3005
R43 VDD.n31 VDD.n11 6.3005
R44 VDD.n15 VDD.n13 6.3005
R45 VDD.n28 VDD.n27 6.3005
R46 VDD.n20 VDD.t15 6.3005
R47 VDD.n21 VDD.n20 6.3005
R48 VDD.n18 VDD.t7 6.3005
R49 VDD.n1 VDD.n18 6.3005
R50 VDD.t1 VDD.t13 1.02197
R51 VDD.n21 VDD.n16 4.5005
R52 VDD.n1 VDD.n17 4.5005
R53 VDD.n31 VDD.n30 4.5005
R54 VDD.n29 VDD.n12 4.33182
R55 VDD.n4 VDD.t20 3.87676
R56 VDD.t31 VDD.n31 3.85233
R57 VDD.t1 VDD.n3 1.05139
R58 VDD.t22 VDD.n14 2.67907
R59 VDD.n13 VDD.n12 2.48918
R60 VDD.n2 VDD.n7 2.47063
R61 VDD.n7 VDD.t17 2.46572
R62 VDD.t1 VDD.n4 2.15097
R63 VDD.t1 VDD.t29 1.48734
R64 VDD.n5 VDD.t13 1.3025
R65 VDD.n3 VDD.t9 0.412564
R66 VDD VDD.t1 1.05581
R67 VDD.t20 VDD.n2 1.95247
R68 VDD.n22 VDD.n21 0.904811
R69 VDD.n27 VDD.t14 0.893357
R70 VDD.n23 VDD.t29 0.4632
R71 VDD.n24 VDD.n23 0.3155
R72 VDD.n23 VDD.n22 0.3155
R73 VDD.n10 VDD.n0 0.230303
R74 VDD.n9 VDD.n8 0.233833
R75 VDD.n7 VDD.n6 0.233833
R76 VDD.n10 VDD.n9 0.233833
R77 VDD.t30 VDD.t31 142.825
R78 VDD.t17 VDD.n0 0.00549791
R79 VDD.t1 VDD.n1 1.34813
R80 VDD.t0 VDD.t1 1.30475
R81 VDD.n22 VDD.t1 1.10637
R82 VDD.t1 VDD.t31 1.05697
R83 GND.n9 GND.t5 54788.8
R84 GND.t20 GND.t19 16444.2
R85 GND.n6 GND.t20 11438.3
R86 GND GND.n5 9028.24
R87 GND.t19 GND.n5 5529.22
R88 GND.n14 GND.n13 4784.3
R89 GND.t21 GND.n9 3721.96
R90 GND.n13 GND.n6 3714.29
R91 GND GND.n4 1.31795
R92 GND.t29 GND.t14 1157.79
R93 GND.t18 GND.n3 1085.23
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
C170 VDD.n22 GND 0.25684f ; **FLOATING
C171 VDD.n23 GND 0.12186f ; **FLOATING
C172 VDD.n24 GND 0.48384f ; **FLOATING
C173 VDD.n25 GND 1.34259f ; **FLOATING
C174 VDD.n26 GND 0.71464f ; **FLOATING
C175 VDD.n27 GND 0.01485f ; **FLOATING
C176 VDD.n29 GND 0.03247f ; **FLOATING
C177 VDD.n30 GND 0.02519f ; **FLOATING
C178 VDD.n31 GND 0.02748f ; **FLOATING
.ends
