sckzor/CMOS_LNB/Layout/LNA/output/LNAMkV__TOP/magic_R/TOP.pex.spice

* NGSPICE file created from TOP.ext - technology: gf180mcuD

.subckt TOP iDAC Input Output BandGap vDAC VDD GND
X0 a_n9884_6770.t0 iDAC OutputBuffer_0/npn_bjt_0/npn_10p00x10p00_0.I1_default_S.t41 OutputBuffer_0/npn_bjt_0/npn_10p00x10p00_0.I1_default_S.t40 nfet_06v0 ad=7.3p pd=21.46u as=2.6p ps=10.52u w=10u l=4u
X1 a_3064_n2566.t0 a_5048_1590.t0 OutputBuffer_0/npn_bjt_0/npn_10p00x10p00_0.I1_default_C.t53 OutputBuffer_0/npn_bjt_0/npn_10p00x10p00_0.I1_default_C.t52 pfet_03v3 ad=2.6p pd=10.52u as=2.6p ps=10.52u w=10u l=0.28u
X2 OutputBuffer_0/npn_bjt_0/npn_10p00x10p00_0.I1_default_S.t32 a_150_194.t0 a_150_194.t0 OutputBuffer_0/npn_bjt_0/npn_10p00x10p00_0.I1_default_S.t31 nfet_03v3 ad=0.273p pd=1.51u as=0.48p ps=2.8u w=0.6u l=0.3u
X3 a_2346_n2146# a_3064_n2566.t0 OutputBuffer_0/npn_bjt_0/npn_10p00x10p00_0.I1_default_S.t24 OutputBuffer_0/npn_bjt_0/npn_10p00x10p00_0.I1_default_S.t23 nfet_03v3 ad=2.6p pd=10.52u as=2.6p ps=10.52u w=10u l=0.28u
X4 Input a_n4608_7484.t0 a_3064_n2566.t0 OutputBuffer_0/npn_bjt_0/npn_10p00x10p00_0.I1_default_S.t42 nfet_03v3 ad=2.6p pd=10.52u as=2.6p ps=10.52u w=10u l=0.28u
X5 a_n6608_7424.t0 a_5194_10442.t0 OutputBuffer_0/npn_bjt_0/npn_10p00x10p00_0.I1_default_C.t13 OutputBuffer_0/npn_bjt_0/npn_10p00x10p00_0.I1_default_C.t12 pfet_06v0 ad=7.7p pd=21.54u as=2.6p ps=10.52u w=10u l=4u
X6 a_2264_4164.t0 a_3058_194.t0 OutputBuffer_0/npn_bjt_0/npn_10p00x10p00_0.I1_default_S.t3 OutputBuffer_0/npn_bjt_0/npn_10p00x10p00_0.I1_default_S.t2 nfet_03v3 ad=0.474p pd=2.78u as=0.273p ps=1.51u w=0.6u l=0.3u
X7 a_2346_n2146# vDAC.t0 a_156_n2566.t0 OutputBuffer_0/npn_bjt_0/npn_10p00x10p00_0.I1_default_S.t11 nfet_03v3 ad=2.6p pd=10.52u as=6p ps=21.2u w=10u l=0.28u
X8 OutputBuffer_0/npn_bjt_0/npn_10p00x10p00_0.I1_default_S.t30 a_3064_n2566.t0 a_2346_n2146# OutputBuffer_0/npn_bjt_0/npn_10p00x10p00_0.I1_default_S.t29 nfet_03v3 ad=13.2p pd=22.64u as=2.6p ps=10.52u w=10u l=0.28u
X9 a_n562_n2146# vDAC.t1 OutputBuffer_0/npn_bjt_0/npn_10p00x10p00_0.I1_default_B.t1 OutputBuffer_0/npn_bjt_0/npn_10p00x10p00_0.I1_default_S.t8 nfet_03v3 ad=2.6p pd=10.52u as=2.6p ps=10.52u w=10u l=0.28u
X10 a_156_n2566.t0 vDAC.t0 a_2346_n2146# OutputBuffer_0/npn_bjt_0/npn_10p00x10p00_0.I1_default_S.t14 nfet_03v3 ad=2.6p pd=10.52u as=2.6p ps=10.52u w=10u l=0.28u
X11 a_3064_n2566.t0 a_n4608_7484.t0 Input OutputBuffer_0/npn_bjt_0/npn_10p00x10p00_0.I1_default_S.t42 nfet_03v3 ad=2.6p pd=10.52u as=2.6p ps=10.52u w=10u l=0.28u
X12 OutputBuffer_0/npn_bjt_0/npn_10p00x10p00_0.I1_default_S.t39 iDAC iDAC OutputBuffer_0/npn_bjt_0/npn_10p00x10p00_0.I1_default_S.t38 nfet_06v0 ad=2.6p pd=10.52u as=7.3p ps=21.46u w=10u l=4u
X13 a_5182_1808.t0 a_3064_n2566.t0 a_5266_2300.t0 OutputBuffer_0/npn_bjt_0/npn_10p00x10p00_0.I1_default_C.t14 pfet_03v3 ad=0.486p pd=2.82u as=0.27p ps=1.5u w=0.6u l=0.3u
X14 OutputBuffer_0/npn_bjt_0/npn_10p00x10p00_0.I1_default_C.t3 a_n6608_7424.t0 a_n4608_7484.t0 OutputBuffer_0/npn_bjt_0/npn_10p00x10p00_0.I1_default_C.t2 pfet_06v0 ad=5.2p pd=20.52u as=5.2p ps=20.52u w=20u l=10u
X15 a_4652_7498# a_n2470_12372# a_5194_10442.t0 OutputBuffer_0/npn_bjt_0/npn_10p00x10p00_0.I1_default_S.t46 nfet_06v0 ad=2.6p pd=10.52u as=7.3p ps=21.46u w=10u l=4u
X16 OutputBuffer_0/npn_bjt_0/npn_10p00x10p00_0.I1_default_C.t34 a_n9884_6770.t0 a_3042_1254.t0 OutputBuffer_0/npn_bjt_0/npn_10p00x10p00_0.I1_default_C.t33 pfet_03v3 ad=0.9p pd=4.2u as=0.48p ps=2.8u w=0.6u l=0.3u
X17 OutputBuffer_0/npn_bjt_0/npn_10p00x10p00_0.I1_default_S.t22 a_3064_n2566.t0 a_2346_n2146# OutputBuffer_0/npn_bjt_0/npn_10p00x10p00_0.I1_default_S.t21 nfet_03v3 ad=2.6p pd=10.52u as=2.6p ps=10.52u w=10u l=0.28u
X18 OutputBuffer_0/npn_bjt_0/npn_10p00x10p00_0.I1_default_C.t40 a_n644_4164.t2 a_n724_1852# OutputBuffer_0/npn_bjt_0/npn_10p00x10p00_0.I1_default_C.t39 pfet_03v3 ad=2.6p pd=10.52u as=2.6p ps=10.52u w=10u l=0.28u
X19 a_2346_n2146# a_3064_n2566.t0 OutputBuffer_0/npn_bjt_0/npn_10p00x10p00_0.I1_default_S.t28 OutputBuffer_0/npn_bjt_0/npn_10p00x10p00_0.I1_default_S.t27 nfet_03v3 ad=2.6p pd=10.52u as=2.6p ps=10.52u w=10u l=0.28u
X20 a_n724_1852# a_n644_4164.t2 OutputBuffer_0/npn_bjt_0/npn_10p00x10p00_0.I1_default_C.t42 OutputBuffer_0/npn_bjt_0/npn_10p00x10p00_0.I1_default_C.t41 pfet_03v3 ad=2.6p pd=10.52u as=2.6p ps=10.52u w=10u l=0.28u
X21 a_2184_1852# a_2264_4164.t2 OutputBuffer_0/npn_bjt_0/npn_10p00x10p00_0.I1_default_C.t21 OutputBuffer_0/npn_bjt_0/npn_10p00x10p00_0.I1_default_C.t20 pfet_03v3 ad=2.6p pd=10.52u as=2.6p ps=10.52u w=10u l=0.28u
X22 a_n6608_7424.t0 BandGap a_4652_7498# OutputBuffer_0/npn_bjt_0/npn_10p00x10p00_0.I1_default_S.t49 nfet_06v0 ad=7.3p pd=21.46u as=2.6p ps=10.52u w=10u l=4u
X23 OutputBuffer_0/npn_bjt_0/npn_10p00x10p00_0.I1_default_C.t51 a_5048_1590.t0 a_3064_n2566.t0 OutputBuffer_0/npn_bjt_0/npn_10p00x10p00_0.I1_default_C.t50 pfet_03v3 ad=2.6p pd=10.52u as=2.6p ps=10.52u w=10u l=0.28u
X24 a_4652_7498# iDAC OutputBuffer_0/npn_bjt_0/npn_10p00x10p00_0.I1_default_S.t37 OutputBuffer_0/npn_bjt_0/npn_10p00x10p00_0.I1_default_S.t36 nfet_06v0 ad=7.3p pd=21.46u as=7.3p ps=21.46u w=10u l=4u
X25 a_134_1254.t0 OutputBuffer_0/npn_bjt_0/npn_10p00x10p00_0.I1_default_B.t4 a_150_194.t0 OutputBuffer_0/npn_bjt_0/npn_10p00x10p00_0.I1_default_C.t9 pfet_03v3 ad=0.267p pd=1.49u as=0.48p ps=2.8u w=0.6u l=0.3u
X26 OutputBuffer_0/npn_bjt_0/npn_10p00x10p00_0.I1_default_C.t7 a_n6608_7424.t0 a_n4608_7484.t0 OutputBuffer_0/npn_bjt_0/npn_10p00x10p00_0.I1_default_C.t6 pfet_06v0 ad=15.4p pd=41.54u as=5.2p ps=20.52u w=20u l=10u
X27 a_3064_n2566.t0 a_5048_1590.t0 OutputBuffer_0/npn_bjt_0/npn_10p00x10p00_0.I1_default_C.t49 OutputBuffer_0/npn_bjt_0/npn_10p00x10p00_0.I1_default_C.t48 pfet_03v3 ad=2.6p pd=10.52u as=2.6p ps=10.52u w=10u l=0.28u
X28 OutputBuffer_0/npn_bjt_0/npn_10p00x10p00_0.I1_default_S.t1 a_3058_194.t0 a_3058_194.t0 OutputBuffer_0/npn_bjt_0/npn_10p00x10p00_0.I1_default_S.t0 nfet_03v3 ad=0.273p pd=1.51u as=0.48p ps=2.8u w=0.6u l=0.3u
X29 Input a_n4608_7484.t0 a_3064_n2566.t0 OutputBuffer_0/npn_bjt_0/npn_10p00x10p00_0.I1_default_S.t42 nfet_03v3 ad=2.6p pd=10.52u as=6p ps=21.2u w=10u l=0.28u
X30 a_n644_4164.t0 a_n4608_7484.t0 a_134_1254.t0 OutputBuffer_0/npn_bjt_0/npn_10p00x10p00_0.I1_default_C.t16 pfet_03v3 ad=0.486p pd=2.82u as=0.267p ps=1.49u w=0.6u l=0.3u
X31 OutputBuffer_0/npn_bjt_0/npn_10p00x10p00_0.I1_default_C.t11 a_5194_10442.t0 a_5194_10442.t0 OutputBuffer_0/npn_bjt_0/npn_10p00x10p00_0.I1_default_C.t10 pfet_06v0 ad=2.6p pd=10.52u as=7.7p ps=21.54u w=10u l=4u
X32 Input a_n4608_7484.t0 a_3064_n2566.t0 OutputBuffer_0/npn_bjt_0/npn_10p00x10p00_0.I1_default_S.t42 nfet_03v3 ad=5.5p pd=21.1u as=2.6p ps=10.52u w=10u l=0.28u
X33 OutputBuffer_0/npn_bjt_0/npn_10p00x10p00_0.I1_default_C OutputBuffer_0/npn_bjt_0/npn_10p00x10p00_0.I1_default_S Output OutputBuffer_0/npn_bjt_0/npn_10p00x10p00_0.I1_default_S npn_10p00x10p00
X34 a_n2470_12372# a_n2470_12372# OutputBuffer_0/npn_bjt_0/npn_10p00x10p00_0.I1_default_S.t60 ppolyf_u_1k_6p0 r_width=0.5u r_length=18.85u
X35 a_2184_1852# a_156_n2566.t0 OutputBuffer_0/npn_bjt_0/npn_10p00x10p00_0.I1_default_S.t35 ppolyf_s r_width=2u r_length=5u
X36 OutputBuffer_0/npn_bjt_0/npn_10p00x10p00_0.I1_default_S.t55 a_156_n2566.t0 a_n562_n2146# OutputBuffer_0/npn_bjt_0/npn_10p00x10p00_0.I1_default_S.t54 nfet_03v3 ad=2.6p pd=10.52u as=2.6p ps=10.52u w=10u l=0.28u
X37 a_n724_1852# OutputBuffer_0/npn_bjt_0/npn_10p00x10p00_0.I1_default_B.t3 OutputBuffer_0/npn_bjt_0/npn_10p00x10p00_0.I1_default_S.t61 ppolyf_s r_width=2u r_length=5u
X38 Output OutputBuffer_0/npn_bjt_0/npn_10p00x10p00_0.I1_default_S.t5 OutputBuffer_0/npn_bjt_0/npn_10p00x10p00_0.I1_default_S.t4 ppolyf_u_1k r_width=4u r_length=4u
X39 OutputBuffer_0/npn_bjt_0/npn_10p00x10p00_0.I1_default_C.t19 a_2264_4164.t2 a_2184_1852# OutputBuffer_0/npn_bjt_0/npn_10p00x10p00_0.I1_default_C.t18 pfet_03v3 ad=2.6p pd=10.52u as=5.3p ps=21.06u w=10u l=0.28u
X40 a_n4608_7484.t0 a_n6608_7424.t0 OutputBuffer_0/npn_bjt_0/npn_10p00x10p00_0.I1_default_C.t5 OutputBuffer_0/npn_bjt_0/npn_10p00x10p00_0.I1_default_C.t4 pfet_06v0 ad=5.2p pd=20.52u as=5.2p ps=20.52u w=20u l=10u
X41 OutputBuffer_0/npn_bjt_0/npn_10p00x10p00_0.I1_default_S Input OutputBuffer_0/npn_bjt_0/npn_10p00x10p00_0.I1_default_S.t43 ppolyf_s r_width=4u r_length=36u
X42 OutputBuffer_0/npn_bjt_0/npn_10p00x10p00_0.I1_default_C.t32 a_n9884_6770.t0 a_134_1254.t0 OutputBuffer_0/npn_bjt_0/npn_10p00x10p00_0.I1_default_C.t31 pfet_03v3 ad=0.9p pd=4.2u as=0.48p ps=2.8u w=0.6u l=0.3u
X43 OutputBuffer_0/npn_bjt_0/npn_10p00x10p00_0.I1_default_B.t2 vDAC.t1 a_n562_n2146# OutputBuffer_0/npn_bjt_0/npn_10p00x10p00_0.I1_default_S.t9 nfet_03v3 ad=2.6p pd=10.52u as=2.6p ps=10.52u w=10u l=0.28u
X44 OutputBuffer_0/npn_bjt_0/npn_10p00x10p00_0.I1_default_C.t36 a_n644_4164.t2 a_n724_1852# OutputBuffer_0/npn_bjt_0/npn_10p00x10p00_0.I1_default_C.t35 pfet_03v3 ad=2.6p pd=10.52u as=5.3p ps=21.06u w=10u l=0.28u
X45 OutputBuffer_0/npn_bjt_0/npn_10p00x10p00_0.I1_default_C.t47 a_5048_1590.t0 a_3064_n2566.t0 OutputBuffer_0/npn_bjt_0/npn_10p00x10p00_0.I1_default_C.t46 pfet_03v3 ad=2.6p pd=10.52u as=5.3p ps=21.06u w=10u l=0.28u
X46 a_n562_n2146# vDAC.t1 OutputBuffer_0/npn_bjt_0/npn_10p00x10p00_0.I1_default_B.t0 OutputBuffer_0/npn_bjt_0/npn_10p00x10p00_0.I1_default_S.t6 nfet_03v3 ad=2.6p pd=10.52u as=6p ps=21.2u w=10u l=0.28u
X47 a_2346_n2146# vDAC.t0 a_156_n2566.t0 OutputBuffer_0/npn_bjt_0/npn_10p00x10p00_0.I1_default_S.t13 nfet_03v3 ad=2.6p pd=10.52u as=2.6p ps=10.52u w=10u l=0.28u
X48 OutputBuffer_0/npn_bjt_0/npn_10p00x10p00_0.I1_default_C.t27 a_2264_4164.t2 a_2184_1852# OutputBuffer_0/npn_bjt_0/npn_10p00x10p00_0.I1_default_C.t26 pfet_03v3 ad=12.9p pd=22.58u as=2.6p ps=10.52u w=10u l=0.28u
X49 a_5266_2300.t0 a_n9884_6770.t0 OutputBuffer_0/npn_bjt_0/npn_10p00x10p00_0.I1_default_C.t28 OutputBuffer_0/npn_bjt_0/npn_10p00x10p00_0.I1_default_C.t14 pfet_03v3 ad=0.48p pd=2.8u as=0.9p ps=4.2u w=0.6u l=0.3u
X50 a_3042_1254.t0 a_156_n2566.t0 a_3058_194.t0 OutputBuffer_0/npn_bjt_0/npn_10p00x10p00_0.I1_default_C.t45 pfet_03v3 ad=0.267p pd=1.49u as=0.48p ps=2.8u w=0.6u l=0.3u
X51 a_2264_4164.t1 a_n4608_7484.t0 a_3042_1254.t0 OutputBuffer_0/npn_bjt_0/npn_10p00x10p00_0.I1_default_C.t17 pfet_03v3 ad=0.486p pd=2.82u as=0.267p ps=1.49u w=0.6u l=0.3u
X52 a_n562_n2146# a_156_n2566.t0 OutputBuffer_0/npn_bjt_0/npn_10p00x10p00_0.I1_default_S.t53 OutputBuffer_0/npn_bjt_0/npn_10p00x10p00_0.I1_default_S.t52 nfet_03v3 ad=2.6p pd=10.52u as=2.6p ps=10.52u w=10u l=0.28u
X53 a_n4608_7484.t0 a_n6608_7424.t0 OutputBuffer_0/npn_bjt_0/npn_10p00x10p00_0.I1_default_C.t1 OutputBuffer_0/npn_bjt_0/npn_10p00x10p00_0.I1_default_C.t0 pfet_06v0 ad=5.2p pd=20.52u as=15.4p ps=41.54u w=20u l=10u
X54 OutputBuffer_0/npn_bjt_0/npn_10p00x10p00_0.I1_default_C.t55 a_5048_1590.t0 a_3064_n2566.t0 OutputBuffer_0/npn_bjt_0/npn_10p00x10p00_0.I1_default_C.t54 pfet_03v3 ad=12.9p pd=22.58u as=2.6p ps=10.52u w=10u l=0.28u
X55 a_n644_4164.t1 a_150_194.t0 OutputBuffer_0/npn_bjt_0/npn_10p00x10p00_0.I1_default_S.t34 OutputBuffer_0/npn_bjt_0/npn_10p00x10p00_0.I1_default_S.t33 nfet_03v3 ad=0.474p pd=2.78u as=0.273p ps=1.51u w=0.6u l=0.3u
X56 OutputBuffer_0/npn_bjt_0/npn_10p00x10p00_0.I1_default_S.t59 a_156_n2566.t0 a_n562_n2146# OutputBuffer_0/npn_bjt_0/npn_10p00x10p00_0.I1_default_S.t58 nfet_03v3 ad=13.2p pd=22.64u as=2.6p ps=10.52u w=10u l=0.28u
X57 a_3064_n2566.t0 a_n4608_7484.t0 Input OutputBuffer_0/npn_bjt_0/npn_10p00x10p00_0.I1_default_S.t42 nfet_03v3 ad=2.6p pd=10.52u as=2.6p ps=10.52u w=10u l=0.28u
X58 a_5182_1808.t0 a_5182_1808.t0 OutputBuffer_0/npn_bjt_0/npn_10p00x10p00_0.I1_default_S.t18 OutputBuffer_0/npn_bjt_0/npn_10p00x10p00_0.I1_default_S.t17 nfet_03v3 ad=0.486p pd=2.82u as=0.273p ps=1.51u w=0.6u l=0.3u
X59 a_n4608_7484.t0 a_n2470_12372# cap_mim_2f0_m4m5_noshield c_width=22u c_length=11u
X60 OutputBuffer_0/npn_bjt_0/npn_10p00x10p00_0.I1_default_S.t48 OutputBuffer_0/npn_bjt_0/npn_10p00x10p00_0.I1_default_S.t48 OutputBuffer_0/npn_bjt_0/npn_10p00x10p00_0.I1_default_S.t47 ppolyf_u_1k r_width=0.5u r_length=6.15u
X61 a_5266_2300.t0 a_n4608_7484.t0 a_5048_1590.t0 OutputBuffer_0/npn_bjt_0/npn_10p00x10p00_0.I1_default_C.t15 pfet_03v3 ad=0.27p pd=1.5u as=0.474p ps=2.78u w=0.6u l=0.3u
X62 OutputBuffer_0/npn_bjt_0/npn_10p00x10p00_0.I1_default_S.t26 a_3064_n2566.t0 a_2346_n2146# OutputBuffer_0/npn_bjt_0/npn_10p00x10p00_0.I1_default_S.t25 nfet_03v3 ad=2.6p pd=10.52u as=2.6p ps=10.52u w=10u l=0.28u
X63 a_n562_n2146# vDAC.t1 OutputBuffer_0/npn_bjt_0/npn_10p00x10p00_0.I1_default_B.t2 OutputBuffer_0/npn_bjt_0/npn_10p00x10p00_0.I1_default_S.t10 nfet_03v3 ad=2.6p pd=10.52u as=2.6p ps=10.52u w=10u l=0.28u
X64 OutputBuffer_0/npn_bjt_0/npn_10p00x10p00_0.I1_default_C.t44 a_n644_4164.t2 a_n724_1852# OutputBuffer_0/npn_bjt_0/npn_10p00x10p00_0.I1_default_C.t43 pfet_03v3 ad=12.9p pd=22.58u as=2.6p ps=10.52u w=10u l=0.28u
X65 OutputBuffer_0/npn_bjt_0/npn_10p00x10p00_0.I1_default_B.t1 vDAC.t1 a_n562_n2146# OutputBuffer_0/npn_bjt_0/npn_10p00x10p00_0.I1_default_S.t7 nfet_03v3 ad=2.6p pd=10.52u as=2.6p ps=10.52u w=10u l=0.28u
X66 a_156_n2566.t0 vDAC.t0 a_2346_n2146# OutputBuffer_0/npn_bjt_0/npn_10p00x10p00_0.I1_default_S.t12 nfet_03v3 ad=2.6p pd=10.52u as=2.6p ps=10.52u w=10u l=0.28u
X67 a_2346_n2146# vDAC.t0 a_156_n2566.t0 OutputBuffer_0/npn_bjt_0/npn_10p00x10p00_0.I1_default_S.t15 nfet_03v3 ad=2.6p pd=10.52u as=2.6p ps=10.52u w=10u l=0.28u
X68 OutputBuffer_0/npn_bjt_0/npn_10p00x10p00_0.I1_default_S.t51 a_156_n2566.t0 a_n562_n2146# OutputBuffer_0/npn_bjt_0/npn_10p00x10p00_0.I1_default_S.t50 nfet_03v3 ad=2.6p pd=10.52u as=2.6p ps=10.52u w=10u l=0.28u
X69 a_n4608_7484.t0 a_n2470_12372# OutputBuffer_0/npn_bjt_0/npn_10p00x10p00_0.I1_default_S.t16 ppolyf_u_1k_6p0 r_width=1u r_length=10u
X70 OutputBuffer_0/npn_bjt_0/npn_10p00x10p00_0.I1_default_C.t30 a_n9884_6770.t0 a_n9884_6770.t0 OutputBuffer_0/npn_bjt_0/npn_10p00x10p00_0.I1_default_C.t29 pfet_03v3 ad=0.828p pd=3.96u as=0.39p ps=2.5u w=0.6u l=0.3u
X71 a_n724_1852# a_n644_4164.t2 OutputBuffer_0/npn_bjt_0/npn_10p00x10p00_0.I1_default_C.t38 OutputBuffer_0/npn_bjt_0/npn_10p00x10p00_0.I1_default_C.t37 pfet_03v3 ad=2.6p pd=10.52u as=2.6p ps=10.52u w=10u l=0.28u
X72 a_2184_1852# a_2264_4164.t2 OutputBuffer_0/npn_bjt_0/npn_10p00x10p00_0.I1_default_C.t25 OutputBuffer_0/npn_bjt_0/npn_10p00x10p00_0.I1_default_C.t24 pfet_03v3 ad=2.6p pd=10.52u as=2.6p ps=10.52u w=10u l=0.28u
X73 OutputBuffer_0/npn_bjt_0/npn_10p00x10p00_0.I1_default_S.t20 a_5182_1808.t0 a_5048_1590.t0 OutputBuffer_0/npn_bjt_0/npn_10p00x10p00_0.I1_default_S.t19 nfet_03v3 ad=0.273p pd=1.51u as=0.468p ps=2.76u w=0.6u l=0.3u
X74 a_n562_n2146# a_156_n2566.t0 OutputBuffer_0/npn_bjt_0/npn_10p00x10p00_0.I1_default_S.t57 OutputBuffer_0/npn_bjt_0/npn_10p00x10p00_0.I1_default_S.t56 nfet_03v3 ad=2.6p pd=10.52u as=2.6p ps=10.52u w=10u l=0.28u
X75 OutputBuffer_0/npn_bjt_0/npn_10p00x10p00_0.I1_default_C.t23 a_2264_4164.t2 a_2184_1852# OutputBuffer_0/npn_bjt_0/npn_10p00x10p00_0.I1_default_C.t22 pfet_03v3 ad=2.6p pd=10.52u as=2.6p ps=10.52u w=10u l=0.28u
R0 vDAC.t1 vDAC.t0 4.08939
R1 vDAC vDAC.t1 8.04976
R2 a_2264_4164.t0 a_2264_4164.t1 11.6517
R3 a_2264_4164.t1 a_2264_4164.t2 10.5024
R4 a_n644_4164.t1 a_n644_4164.t2 10.5024
R5 a_n644_4164.t0 a_n644_4164.t1 10.3338
R6 OutputBuffer_0/npn_bjt_0/npn_10p00x10p00_0.I1_default_S OutputBuffer_0/npn_bjt_0/npn_10p00x10p00_0.I1_default_B.n10 45246.1
R7 OutputBuffer_0/npn_bjt_0/npn_10p00x10p00_0.I1_default_B.n34 OutputBuffer_0/npn_bjt_0/npn_10p00x10p00_0.I1_default_B.n33 6351.09
R8 OutputBuffer_0/npn_bjt_0/npn_10p00x10p00_0.I1_default_B.n4 OutputBuffer_0/npn_bjt_0/npn_10p00x10p00_0.I1_default_B.n53 4915.22
R9 OutputBuffer_0/npn_bjt_0/npn_10p00x10p00_0.I1_default_B.n1 OutputBuffer_0/npn_bjt_0/npn_10p00x10p00_0.I1_default_B.n39 1287.24
R10 OutputBuffer_0/npn_bjt_0/npn_10p00x10p00_0.I1_default_S OutputBuffer_0/npn_bjt_0/npn_10p00x10p00_0.I1_default_B.n24 1209.54
R11 OutputBuffer_0/npn_bjt_0/npn_10p00x10p00_0.I1_default_B.n54 OutputBuffer_0/npn_bjt_0/npn_10p00x10p00_0.I1_default_B.n22 1085.23
R12 OutputBuffer_0/npn_bjt_0/npn_10p00x10p00_0.I1_default_S OutputBuffer_0/npn_bjt_0/npn_10p00x10p00_0.I1_default_B.n35 872.721
R13 OutputBuffer_0/npn_bjt_0/npn_10p00x10p00_0.I1_default_S OutputBuffer_0/npn_bjt_0/npn_10p00x10p00_0.I1_default_B.n3 1071.13
R14 OutputBuffer_0/npn_bjt_0/npn_10p00x10p00_0.I1_default_B.n11 OutputBuffer_0/npn_bjt_0/npn_10p00x10p00_0.I1_default_B.n10 701.38
R15 OutputBuffer_0/npn_bjt_0/npn_10p00x10p00_0.I1_default_B.n38 OutputBuffer_0/npn_bjt_0/npn_10p00x10p00_0.I1_default_S 582.428
R16 OutputBuffer_0/npn_bjt_0/npn_10p00x10p00_0.I1_default_B.n53 OutputBuffer_0/npn_bjt_0/npn_10p00x10p00_0.I1_default_B.n10 557.803
R17 OutputBuffer_0/npn_bjt_0/npn_10p00x10p00_0.I1_default_B.n2 OutputBuffer_0/npn_bjt_0/npn_10p00x10p00_0.I1_default_B.n1 1.16224
R18 OutputBuffer_0/npn_bjt_0/npn_10p00x10p00_0.I1_default_B.n6 OutputBuffer_0/npn_bjt_0/npn_10p00x10p00_0.I1_default_B.n7 0.465451
R19 OutputBuffer_0/npn_bjt_0/npn_10p00x10p00_0.I1_default_B.n54 OutputBuffer_0/npn_bjt_0/npn_10p00x10p00_0.I1_default_B.n4 166.631
R20 OutputBuffer_0/npn_bjt_0/npn_10p00x10p00_0.I1_default_B.n28 OutputBuffer_0/npn_bjt_0/npn_10p00x10p00_0.I1_default_B.n22 119.632
R21 OutputBuffer_0/npn_bjt_0/npn_10p00x10p00_0.I1_default_B.n31 OutputBuffer_0/npn_bjt_0/npn_10p00x10p00_0.I1_default_B.n30 113.936
R22 OutputBuffer_0/npn_bjt_0/npn_10p00x10p00_0.I1_default_B.n32 OutputBuffer_0/npn_bjt_0/npn_10p00x10p00_0.I1_default_B.n31 113.936
R23 OutputBuffer_0/npn_bjt_0/npn_10p00x10p00_0.I1_default_B.n3 OutputBuffer_0/npn_bjt_0/npn_10p00x10p00_0.I1_default_B.n27 90.6438
R24 OutputBuffer_0/npn_bjt_0/npn_10p00x10p00_0.I1_default_B.n27 OutputBuffer_0/npn_bjt_0/npn_10p00x10p00_0.I1_default_B.n24 90.6438
R25 OutputBuffer_0/npn_bjt_0/npn_10p00x10p00_0.I1_default_B.n11 OutputBuffer_0/npn_bjt_0/npn_10p00x10p00_0.I1_default_B.n0 2.50409
R26 OutputBuffer_0/npn_bjt_0/npn_10p00x10p00_0.I1_default_B.n34 OutputBuffer_0/npn_bjt_0/npn_10p00x10p00_0.I1_default_B.n32 75.4825
R27 OutputBuffer_0/npn_bjt_0/npn_10p00x10p00_0.I1_default_B.n30 OutputBuffer_0/npn_bjt_0/npn_10p00x10p00_0.I1_default_B.n29 64.8011
R28 OutputBuffer_0/npn_bjt_0/npn_10p00x10p00_0.I1_default_B.n39 OutputBuffer_0/npn_bjt_0/npn_10p00x10p00_0.I1_default_B.n38 56.1109
R29 OutputBuffer_0/npn_bjt_0/npn_10p00x10p00_0.I1_default_B.n35 OutputBuffer_0/npn_bjt_0/npn_10p00x10p00_0.I1_default_B.n34 50.2582
R30 OutputBuffer_0/npn_bjt_0/npn_10p00x10p00_0.I1_default_B.n29 OutputBuffer_0/npn_bjt_0/npn_10p00x10p00_0.I1_default_B.n28 49.135
R31 OutputBuffer_0/npn_bjt_0/npn_10p00x10p00_0.I1_default_B.n23 OutputBuffer_0/npn_bjt_0/npn_10p00x10p00_0.I1_default_B.t4 41.7767
R32 OutputBuffer_0/npn_bjt_0/npn_10p00x10p00_0.I1_default_S OutputBuffer_0/npn_bjt_0/npn_10p00x10p00_0.I1_default_B.n4 139.071
R33 OutputBuffer_0/npn_bjt_0/npn_10p00x10p00_0.I1_default_S OutputBuffer_0/npn_bjt_0/npn_10p00x10p00_0.I1_default_B.n37 13.51
R34 OutputBuffer_0/npn_bjt_0/npn_10p00x10p00_0.I1_default_B.n7 OutputBuffer_0/npn_bjt_0/npn_10p00x10p00_0.I1_default_B.n39 2.81488
R35 OutputBuffer_0/npn_bjt_0/npn_10p00x10p00_0.I1_default_B.n37 OutputBuffer_0/npn_bjt_0/npn_10p00x10p00_0.I1_default_B.n36 9.7005
R36 OutputBuffer_0/npn_bjt_0/npn_10p00x10p00_0.I1_default_B.n47 OutputBuffer_0/npn_bjt_0/npn_10p00x10p00_0.I1_default_B.n12 4.48301
R37 OutputBuffer_0/npn_bjt_0/npn_10p00x10p00_0.I1_default_B.n9 OutputBuffer_0/npn_bjt_0/npn_10p00x10p00_0.I1_default_B.n45 4.48301
R38 OutputBuffer_0/npn_bjt_0/npn_10p00x10p00_0.I1_default_B.n45 OutputBuffer_0/npn_bjt_0/npn_10p00x10p00_0.I1_default_B.n13 4.48301
R39 OutputBuffer_0/npn_bjt_0/npn_10p00x10p00_0.I1_default_B.n25 OutputBuffer_0/npn_bjt_0/npn_10p00x10p00_0.I1_default_B.n24 7.86063
R40 OutputBuffer_0/npn_bjt_0/npn_10p00x10p00_0.I1_default_B.n14 OutputBuffer_0/npn_bjt_0/npn_10p00x10p00_0.I1_default_B.n51 4.48301
R41 OutputBuffer_0/npn_bjt_0/npn_10p00x10p00_0.I1_default_B.n15 OutputBuffer_0/npn_bjt_0/npn_10p00x10p00_0.I1_default_B.n50 4.48301
R42 OutputBuffer_0/npn_bjt_0/npn_10p00x10p00_0.I1_default_B.n16 OutputBuffer_0/npn_bjt_0/npn_10p00x10p00_0.I1_default_B.n49 4.48301
R43 OutputBuffer_0/npn_bjt_0/npn_10p00x10p00_0.I1_default_B.n48 OutputBuffer_0/npn_bjt_0/npn_10p00x10p00_0.I1_default_B.n17 7.83746
R44 OutputBuffer_0/npn_bjt_0/npn_10p00x10p00_0.I1_default_B.n18 OutputBuffer_0/npn_bjt_0/npn_10p00x10p00_0.I1_default_B.n43 4.48301
R45 OutputBuffer_0/npn_bjt_0/npn_10p00x10p00_0.I1_default_B.n19 OutputBuffer_0/npn_bjt_0/npn_10p00x10p00_0.I1_default_B.n42 4.48301
R46 OutputBuffer_0/npn_bjt_0/npn_10p00x10p00_0.I1_default_B.n20 OutputBuffer_0/npn_bjt_0/npn_10p00x10p00_0.I1_default_B.n41 4.48301
R47 OutputBuffer_0/npn_bjt_0/npn_10p00x10p00_0.I1_default_B.n21 OutputBuffer_0/npn_bjt_0/npn_10p00x10p00_0.I1_default_B.n40 4.48301
R48 OutputBuffer_0/npn_bjt_0/npn_10p00x10p00_0.I1_default_S OutputBuffer_0/npn_bjt_0/npn_10p00x10p00_0.I1_default_B.n22 7.43771
R49 OutputBuffer_0/npn_bjt_0/npn_10p00x10p00_0.I1_default_B.n36 OutputBuffer_0/npn_bjt_0/npn_10p00x10p00_0.I1_default_B.n26 7.23383
R50 OutputBuffer_0/npn_bjt_0/npn_10p00x10p00_0.I1_default_B.n27 OutputBuffer_0/npn_bjt_0/npn_10p00x10p00_0.I1_default_B.n26 5.2005
R51 OutputBuffer_0/npn_bjt_0/npn_10p00x10p00_0.I1_default_B.n36 OutputBuffer_0/npn_bjt_0/npn_10p00x10p00_0.I1_default_B.n3 5.2005
R52 OutputBuffer_0/npn_bjt_0/npn_10p00x10p00_0.I1_default_B.n2 OutputBuffer_0/npn_bjt_0/npn_10p00x10p00_0.I1_default_B.n52 7.27908
R53 OutputBuffer_0/npn_bjt_0/npn_10p00x10p00_0.I1_default_B.n14 OutputBuffer_0/npn_bjt_0/npn_10p00x10p00_0.I1_default_B.n8 1.4837
R54 OutputBuffer_0/npn_bjt_0/npn_10p00x10p00_0.I1_default_B.n8 OutputBuffer_0/npn_bjt_0/npn_10p00x10p00_0.I1_default_B.n15 1.4837
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
R108 OutputBuffer_0/npn_bjt_0/npn_10p00x10p00_0.I1_default_C.t35 OutputBuffer_0/npn_bjt_0/npn_10p00x10p00_0.I1_default_C.n55 2479.33
R109 OutputBuffer_0/npn_bjt_0/npn_10p00x10p00_0.I1_default_C.n52 OutputBuffer_0/npn_bjt_0/npn_10p00x10p00_0.I1_default_C.n51 569.928
R110 OutputBuffer_0/npn_bjt_0/npn_10p00x10p00_0.I1_default_C.n43 OutputBuffer_0/npn_bjt_0/npn_10p00x10p00_0.I1_default_C.n42 562.947
R111 OutputBuffer_0/npn_bjt_0/npn_10p00x10p00_0.I1_default_C.t18 OutputBuffer_0/npn_bjt_0/npn_10p00x10p00_0.I1_default_C.n65 555.644
R112 OutputBuffer_0/npn_bjt_0/npn_10p00x10p00_0.I1_default_C.n80 OutputBuffer_0/npn_bjt_0/npn_10p00x10p00_0.I1_default_C.t29 448.039
R113 OutputBuffer_0/npn_bjt_0/npn_10p00x10p00_0.I1_default_C.t2 OutputBuffer_0/npn_bjt_0/npn_10p00x10p00_0.I1_default_C.t0 416.139
R114 OutputBuffer_0/npn_bjt_0/npn_10p00x10p00_0.I1_default_C.t4 OutputBuffer_0/npn_bjt_0/npn_10p00x10p00_0.I1_default_C.t6 416.139
R115 OutputBuffer_0/npn_bjt_0/npn_10p00x10p00_0.I1_default_C.t48 OutputBuffer_0/npn_bjt_0/npn_10p00x10p00_0.I1_default_C.t46 406.091
R116 OutputBuffer_0/npn_bjt_0/npn_10p00x10p00_0.I1_default_C.t50 OutputBuffer_0/npn_bjt_0/npn_10p00x10p00_0.I1_default_C.t48 406.091
R117 OutputBuffer_0/npn_bjt_0/npn_10p00x10p00_0.I1_default_C.t52 OutputBuffer_0/npn_bjt_0/npn_10p00x10p00_0.I1_default_C.t50 406.091
R118 OutputBuffer_0/npn_bjt_0/npn_10p00x10p00_0.I1_default_C.n52 OutputBuffer_0/npn_bjt_0/npn_10p00x10p00_0.I1_default_C.n34 304.104
R119 OutputBuffer_0/npn_bjt_0/npn_10p00x10p00_0.I1_default_C.n65 OutputBuffer_0/npn_bjt_0/npn_10p00x10p00_0.I1_default_C.n54 304.104
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
